sand0636/RFID/RFID-Network-Build-master/Documentation/images/data flow overview.png

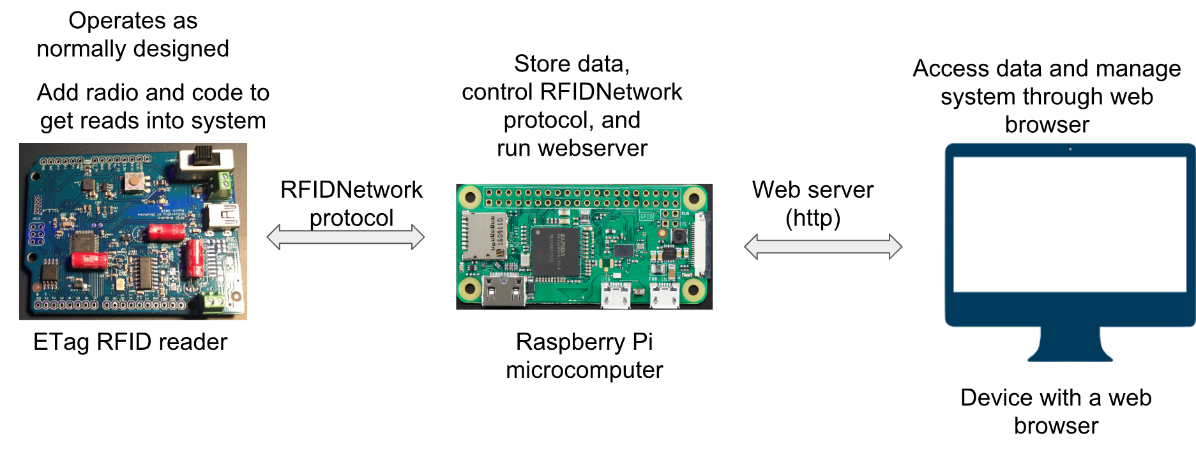
RFID-Network-Build-master/Documentation/images/data flow overview.png
