sand0636/RFID/RFID-Network-Build-master/other/3d test bracket/test1.stl

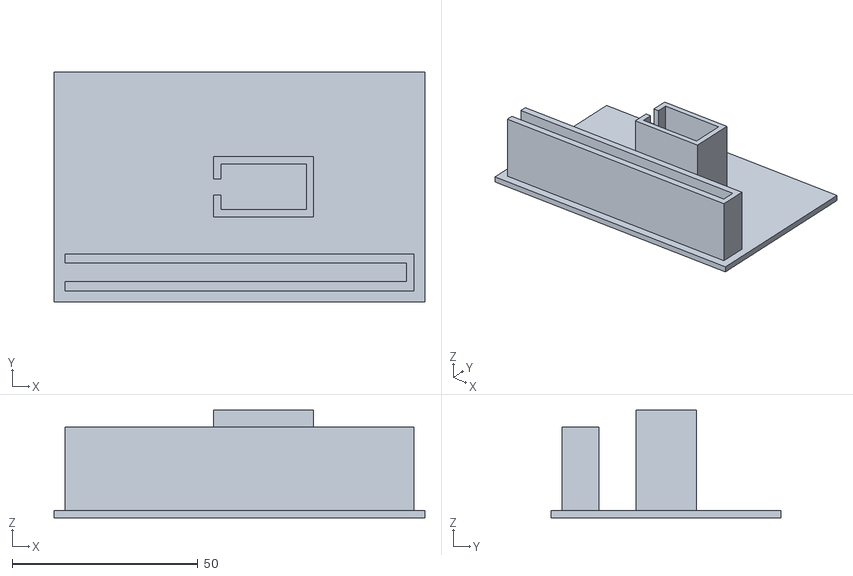
[picture p4: CAD file, 2019-05-10]
RFID-Network-Build-master/other/3d test bracket/test1.stl
100.0 x 62.0 x 29.0
