sand0636/RFID/RFID-Network-Build-master/other/3d test bracket/test2.stl

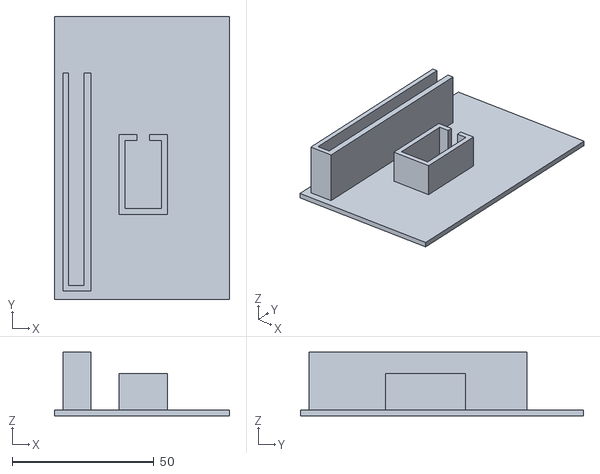
[picture p5: CAD file, 2019-05-10]
RFID-Network-Build-master/other/3d test bracket/test2.stl
62.0 x 100.0 x 22.5
