sand0636/RFID/(list of files, cad)

Other CAD files:
RFID-Network-Build-master/other/3d test bracket/test1_recover.dwg
RFID-Network-Build-master/other/3d test bracket/test1.dwg
RFID-Network-Build-master/other/3d test bracket/test2.dwg
