sand0636/RFID/RFID-Network-Build-master/Documentations/readme.md

# Documentation

This folder contains the documentation for the project.  Most of the documentation hasn't been started but it should be updated in a couple months.

## Contents:
- Images: Contains screenshots from the RPi installation process not currently used and images demonstrating the importance of a mesh layer.
- Protocol: A collection of protocol used in the system that will be included in the final tecnical manual.
- suggestions: A collection of hints and strategies to help with development and generally making life easier.
