sand0636/RFID/RFID-Network-Build-master/server/secure/settings.html

# Settings

- System information
- Wireless
- Radio
- Save data
- Database
  - Add test data
  - Delete table data

#### System information

Server type:

Field site Other

System name:

Submit

System time:

System timezone:

System up time:

Architecture:

Operating system:

CPU usage:

Free memory:

Total memory:

Percent memory used:

##### Reboot or shutdown system

Reboot Shutdown

#### Wireless

##### Wireless mode

Use access poing (create network) Use wifi (connect to network)

Use the device as an access point(ap) (creates a network where you can connect to the RPi using a wifi equipped device) or with wifi (connect to a network using the RPi). The currently used option is in blue. It is best ot use the RPi in AP mode when it is in the field so you can connect to it. This requires the system to reboot which may take up to a minute!

##### Access point

SSID (name):

Passphrase:

Change access point SSID or assphrase

##### WiFi

This does not show every WiFi saved on the RPi, only the one saved in settings.json. So don't be alarmed if you don't see a WiFi listed here that you haven't entered.

SSID (name):

Passphrase:

Change WiFi SSID or passphrase

#### Save data

This is where you can easily download data off of the server. Bird, box and reads data are stored as seporate CSVs and placed in one ZIP. This ZIP is only created when it is told to by pressing the "Update ZIP" button. The data can be downloaded through the browser by pressing the "Download ZIP" button. If a USB is inserted into the Pi then the ZIP can quickly be saved onto the drive by pressing the "Place ZIP on flash drive" button.

Update ZIP Download ZIP Place ZIP on flash drive

#### Radio

On Off

CE:

CSN:

Channel:

Data rate:

PA level:

The system must be rebooted to change the radio settings. Submit

#### Database

##### Add test data

This adds test data to all of the tables in the database without deleting anything. The data that is entered can be seen below

###### Birds:

rfidTag | bandID | Sex | age | taggedDateTime | taggedLocation | comment
0123456789 | ABCDEFGHIJ | F | 17 | N/a | stl | sis
6666666666 | BENWASHERE | M | 20 | bd | stl | ben
9876543210 | HELLOTOALL | M | 13 | n/a | stl | bro
0246813579 | A0B1C2D3E4 | F | 1.5 | n/a | Bloomington | rand

Add test data

##### Delete all data

This deletes all the data from the selected database. This only affects the local server, but if this is the sync server it will affect all other servers. This cannot be undone!!!

Delete bird data Delete box data Delete reads data Delete all data
