sand0636/RFID/RFIDNetwork User Manual.pdf

# RFIDNetwork User Manual

### Ben S. Duggan Indiana University: School of Informatics, Computing and Engenering dugganbens@gmail.com

### Last edit: January 24, 2019 Pre-release v0.9.0

## Contents

1 Preface | 3
2 Instillation | 3
3 Server (Raspberry Pi) | 12
4 RFIDNetwork class (Arduino code) | 21

5 Protocols | 21
6 Tests | 21
7 Appendix | 21

## 1 Preface

RFID technology has become cheaper and more accessible making it possible for a large number of readers to be deployed. While this delivers a large amount of useful data it can be hard to collect and manage it. For this reason this system was designed which collects reads from RFID readers and wirelessly transmits them to a central server. The goal of the system was to make an open-source system to wireless collect, store and manage RFID data.

To implement the system each reader needs to have an Arduino and radio module. However, if the reader is Arduino based, like the ETAG, then only a radio module is needed. To save the read to the server you simply need to pass the RFID tag into the RFIDNetwork class and it will be wireless sent to the server. It is up to the person running the code to get the RFID tag onto the Arduino and into the RIFDNetwork class (as this is largely reader specific) but sample code for the ETAG is provided along with code to use get reads from readers with RS-232 serial port, like the Gen. 2 reader.

The server is a Raspberry Pi (RPi) microcomputer and the Zero W is recommended as it is low cost, low power and comes with a Wifi module, but any RPi should work. Additionally the server needs a real time clock (RTC) to know what time it is and a radio module to communicate with the Arduinos. The RPi stores all of the RFID reads it received and runs a web server that allows users to view or manage the RFID data.

All of the code and documentation is stored on GitHub at github.com/BenSDuggan/RFID-Network/. If you find a problem with the code you can email me at dugganbens@gmail.com or create and issue on the GitHub page.

## 2 Instillation

This section shows how to install the system. While I have tried to make the system easy to install, there are some things which cannot be avoided like soldering. Most of the things that you will find difficult are things lots of people have had to learn on their own (including me) so you shouldn’t be disgruntled. If you get stuck with something you can probably find the answer with a quick Google search. Most things are explained thoroughly but the one thing I can’t help with is teaching you to solder. Soldering is the technique to electrically connect two wires. If you haven’t soldered before just watch this video https://www.youtube.com/watch?v=BLfXXRfRIzY (or any other you can find) and practice on some spare wires. You can pick up a cheap soldering iron on amazon for less than $30.
With that said if you have any problems you can send me an email and I’ll try to help. I’ve also made a video showing the entire installation process. You can find it here: . make video

### 2.1 The radio

For this system to work every device in the network needs to communicate with each other. This is done using the nRF24L01+PA+LNA Wireless Transceiver or shortened to the nRF24. This is a 2.4-2.48 GHz transceiver which means that it can send and receive data at the same frequency your WiFi uses. Each radio has the option of using 126 different channels (different field sites) different transmission speeds (250 KBPS, 1 MBPS and 2 MBPS) and 4 different power settings. It can connect to 6 other radios (expanded to 127 in software) and has a <1 mA sleep power consumption. You can find out more about the radios by viewing the datasheet (https://www.sparkfun.com/datasheets/Components/SMD/nRF24L01Pluss_Preliminary_Product_Specification_v1_0.pdf). (https://www.sparkfun.com/datasheets/Components/SMD/nRF24L01Pluss_Preliminary_Product_Specification_v1_0.pdf)
There are two common versions of the nRF24: short range and long range (see long range below). From my testing the short range version are inadequate under almost all circumstances so only the long range should be used. The long range model has an advertised range of 1000 m but I have only tested up to 600 m (more on the radio tests in section 6.1). To allow for greater range and more than 6 radios to be connected a software library is used which creates a mesh network. This is explained in section 4.3. These radios and the RFIDNetwork class rely on the SPI protocol, so while it has only been tested on Arduinos and Raspberry Pis it should work on other microcontrollers that support SPI. You can also find everything needed with approximate pricing in the appendix (7.1)
The radio comes with 8 2.54 mm pins called male headers. The recommended way to connect the radio is by soldering male headers to the microcontroller and then connecting a wire with female headers between the microcontroller and radio. See the image below. A modification needs to be made to the radios to ensure reliable performance due to an inadequate supply of power to the IC of the radio. This can be done by buying a power module (seen in the image below) or soldering a 4.7µF-10µF capacitor between the ground and VCC pin (1 and 2) on the radio module.

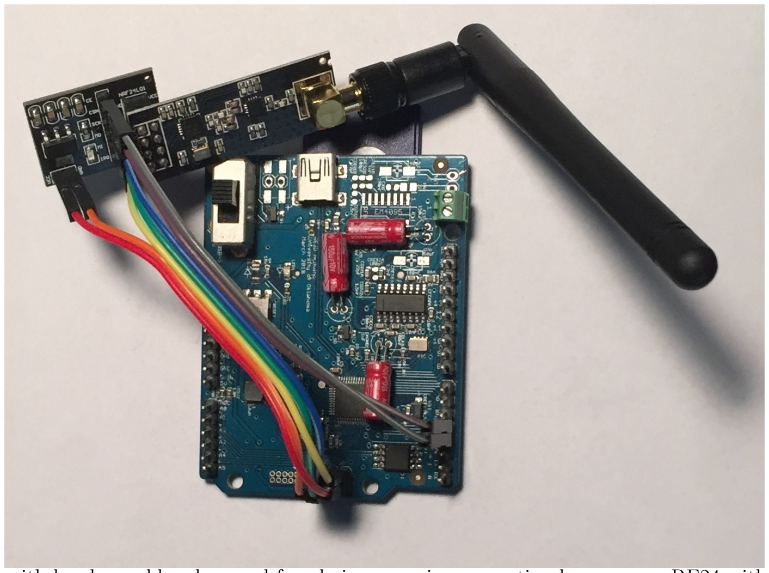
[picture p12: figure]

ETAG with headers soldered on and female jumper wire connecting long range nRF24 with power module to board.

### 2.1.1 Setting up the radio

The radio will come in a static protector bag. Take it out of the bag and screw the antenna onto the receptacle. It should look like the image above. To ensure reliable performance either a power module or capacitor needs to be added. The power module makes it easier to switch in the field but is more expensive and uses more power (due to having a power indicator LED)than the capacitor. The capacitor requires soldering but is cheaper and should result in the same performance.

Using the power module: Notice that there are two rows of 4 male pins on the radio and 2 rows of 4 female pins on the power module. Insert the radio into the power module so that all pins are seated. Next connect 7 female wires to the wires on the power module. Make sure that every pin on the power module is connected except for the pin labeled IRQ (looks like RO). Make sure that you only plug the VCC (pin 2) into 5V otherwise the module might get enough power. This should look like the picture above.

Using the capacitors: It is recommended to use a 4.7-10 capacitor with the radio. Solder the capacitor between pins 1 and 2 of the top of the radio (pin 1 has the white square around it and 2 is the the right, in the different row of 4 pins). If you’re using an electrolytic capacitor then make sure the negative lead is soldered to VCC. Next connect 7 female wires to the wires on the radio.

You don’t need to attached the IRQ (pin 8, located farthest away from pin 1 and on the side closer to the antenna). Make sure that you plug the VCC (pin 2) into 3.3V otherwise the module might get damaged. This should look like the picture below:

long range with capacitor and wires Long range nRF24 radio with capacitor and wires attached.

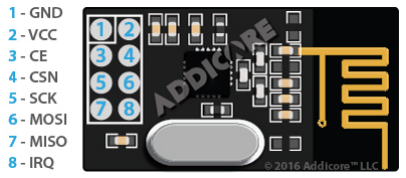
[picture p13: figure]

nRF24 pin layout with numbering and purpose.

### 2.2 Arduino (RFID reader)

The Arduino is used to get the RFID tag onto the server and saved. This system should work with any RFID reader but you need to get the reads onto an Arduino supported microcontroller. With Arduino based readers, like the ETAG, there is no need to purchase another Arduino as it is open-source and Arduino based. However, with other readers that aren’t Arduino based, like the Gen. 2 by Eli Bridge et al., a device must be used to get the reads onto an Arduino. This makes the setup more complicated and more expensive. We’ll use both of these RFID readers as examples of how this system can be setup. The software ran on the Arduinos is the same regardless of the reader, just will a few minor changes.

### 2.2.1 Hardware

Arduino based RFID readers (e.g. ETAG)

To connect the radio to the Arduino (either an Arduino based RFID reader or one that will be used to communicate with a reader) you just need to connect the jumper wires from the radio to the board. This means identifying which pins are used for SPI, digital, ground and power pins are (making sure you correctly use either 3.3V or 5V, depending on your configuration). The easiest way to identify where the SPI pins are is by using the 6 pin ISCP header. You may need to solder pins to it but it has as standard format (shown below). The VCC is likely at 5V so if you are using the capacitor you shouldn’t use this VCC and should use the 3.3V output pin and the board. The ISCP VCC pin on the ETAG is at 5V.

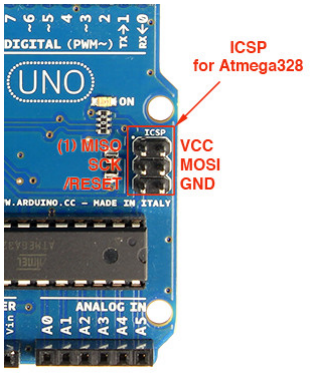
[picture p14: figure]

ISCP 6 pin header on Arudino Uno(ETAG) with pins labeled.

That takes care of GND, VCC, SCK, MOSI, MISO and IRQ (which isn’t used). The CE and CSN pin need to be connected to two digital pins and is defined in software. By default CE is set to digital pin 3 and CSN is set to digital pin 4 but you can change this if you’d like. This boils down to the following wiring as shown in the table below and the image showing the final setup.

Table showing pin connections between radio and Arduino.
Power module (from module) | Capacitor (from radio)
nRF24 pins | Arduino pins | nRF2 ins | Arduino pins
1. GND | GND on ICSP | 1. GND | GND on ICSP
2. VCC | 5V(VCC on ICSP) | 2. VCC | 3.3V on board
3. CE | digital pin 3 | 3. CE | digital pin 3
4. CSN | digital pin 4 | 4. CSN | digital pin 4
5. SCK | SCK on ICSP | 5. SCK | SCK on ICSP
6. MOSI | MOSI on ICSP | 6. MOSI | MOSI on ICSP
7. MISO | MISO on ICSP | 7. MISO | MISO on ICSP
8. IRQ | not used | 8. IRQ | not used

ETAG with headers soldered on and female jumper wire connecting long range nRF24 with power module to board (note that CE is connected to 2 and CSN is connected to 3).

This is all that needs to be done to setup the hardware on Arduino based RFID readers like the ETAG.

General way of adding system (e.g. Gen. 2)

For RFID readers that are not Arduino based, like the Gen. 2, there is a lot of work that needs to be done. The reason for this is that we need to get the RFID data off of the board and into the code, which is written for Arduinos. This means that you have to purchase an Arduino, any extra equipment to create an interface between the reader and Arduino and add the radio to it. Any Arduino should do but I recommend the Arduino Nano as it is common, cheap, low power, and easy to use. Once you do this attach the radio using the instructions above.
Next we need a way to get the data off of the RFID reader. RFID readers typically have a way for people to configure and see what tags the reader is currently reading. On the Gen. 2 there is a RS-232 serial port where you can attach a cable and connect it to your computer. When you connect to it you can view the settings and see what reads are coming into the reader. This provides us with a way to get the data off of the reader into an Arduino.
As Arduinos cannot us USB (without a shield), we’ll have to add a device that the Arduino understands, a RS232 to TTL with a null modem. Attach this to the Gen. 2 and try to secure it with screws. Make sure that you handle the Gen. 2 with care now as there is a large lever arm attached to the RS232 connector. Notice that there are 2 rows of 4 pins on the connector. Attach a wire to ground, VCC and txt pins (you may have to experiment with using the rxt pin). Check to see if the connector uses 3.3V or 5V (mine used 5V). Connect that wire to the pin giving that voltage on the reader. If the voltage of the connector and radio are the same and you only have one pin of that voltage you can plug the VCC cable from the radio into the extra VCC pin on the converter. Next connect the wire that leads to ground and the last wire to digital pin 5. This is the setup I went through with my RS232 to TTL converter (link in Appendix).
Lastly the Arduino needs to get powered. If the RFID reader has pins to output power (VCC) then you can solder wires to it and a ground pin. Make sure that the output voltage on the RFID reader is not greater than the input voltage the Arduino can take. If that condition holds then connect the VCC wire to the VIN pin on the Arduino and ground wire to the ground pin on the Arduino. If this is not an option on your RFID reader then you might be able to add wires to the battery powering the reader or just use a separate battery to power the Arduino.

gen. 2 setup Gen. 2 board with RS-232 to TTL and null modem and long range nRF24 connected to Arduino, powered by the Gen.2.

### 2.2.2 Software

If you don’t already have the Arduino IDE downloaded it from their website (https://www.arduino.cc/en/Main/Software) and install it. The Arduino scripts that work with this system are found in the arduino folder of the repository. If you haven’t already downloaded the GitHub repository (http://github.com/BenSDuggan/RFID-Network) you should do so now.
There are several codes that you can choose to upload. If you just want to test the code you should upload the send on interval code found in the sendOnInterval folder. There is a version of the code that works with all boards (sendOnIntervalAll) and one written just for the ETAG (sendOnIntervalETAG) that uses the SD card and RTC on the reader. If you are using the Gen. 2 or ETAG there is code provided that will read reads off of the antenna with out affecting reader performance. The Gen. 2 script is called RFIDNetworkGen2 and the ETAG script is called RFIDNetworkeETAG. Once you have selected the code you wish to use, connect the Arduino to the computer using the a USB, check to see that the correct board and port are selected. You’re can now upload the code by clicking the upload button.

### 2.3 Server

The server is central brains of the system. It is responsible for communicating with the RFID readers, saving data, making it viewable and more. Each field site needs one server. The server is designed to be a Raspberry Pi (RPi) mini computer. These are less than $20 and provide a full Linux interface. It is recommended to use the Raspberry Pi Zero W as it is small, low power, inexpensive and has WiFi included but it should work with any Raspberry Pi.

rpi diagram Raspberry Pi Zero W

### 2.3.1 Hardware

Your RPi might come without the pins soldered on. If this is the case then solder the pins to the board. Pin 1 is the closest to the middle and the SD slot and pin 2 is next to in on the other long set of pins. You can view the Raspberry Pi pins at pinout.xyz/.
In addition to the RPi you will need a radio for it and a real time clock (RTC). The RTC allows the RPi to know what time it is, which is not possible in the field where there is no internet. The RTC module connects to the RPi using pins 1,3,5,7,9 with pin 1 connected to the VCC (+) pin on the RTC. Next the radio needs to be connected per the table below.

Table showing pin connections between radio and Rapsberry Pi.
Power module (from module) | Capacitor (from radio)
nRF24 pins | Arduino pins | nRF2 ins | Arduino pins
1. GND | Pin 20 | 1. GND | Pin 20
2. VCC | Pin 4 | 2. VCC | Pin 17
3. CE | Pin 22(GPIO 25) | 3. CE | Pin 22(GPIO 25)
4. CSN | Pin 24 | 4. CSN | Pin 24
5. SCK | Pin 23(GPIO 11) | 5. SCK | Pin 23(GPIO 11)
6. MOSI | Pin 19(GPIO 10) | 6. MOSI | Pin 19(GPIO 10)
7. MISO | Pin 21(GPIO 9) | 7. MISO | Pin 21(GPIO 9)
8. IRQ | not used | 8. IRQ | not used

The RPi should now look like this:

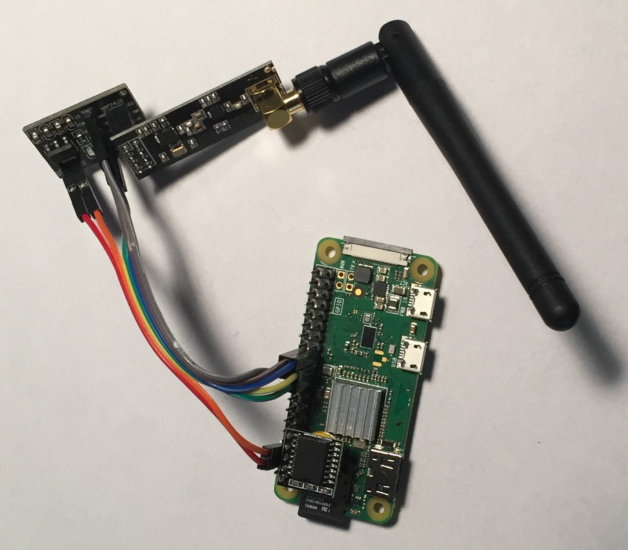
[picture p15: figure]

Raspberry Pi Zero W with RTC and radio.

### 2.3.2 Software

Download the zip of the NOOBs (new out of box) operating system for the Raspberry Pi found at https://www.raspberrypi.org/downloads/noobs/. Unzip the folder and install it according the the readme instructions. Install the operating system. If you have problems with this step you can refer to this video https://www.youtube.com/watch?v=iJbjAJpJA84.
Now you need to install the RFID Network software. This can be done automatically or manually. The manual installation instructions, which are incredibly tedious, are found in the following path: RFIDNetwork RPi install list.md. For that reason you probably want to use the automatic script. Start by opening the terminal by clicking the icon in the top left corner that is a gray rectangle with white text that looks like ”> ” (shown below). If you only have a key board plugged in you can click the windows key, arrow down to Accessories, arrow right, arrow down to Terminal and press enter.


RPi desktop showing terminal icon.

The terminal is a text only interface where you type commands and then run them by typing enter. Type ”wget https://bit.ly/2CCI6Ok” then press enter. Next type ”chmod +x 2CCI6Ok” and press enter. Finally type ”./2CCI6Ok” and type enter. This will start the instillation process. It’s recommended that you type ”y” when promoted to enter a yes or no answer. Remember which password you set for the admin username and password as it is used for the database and secure server settings. there is currently no way to change the username or password without doing it yourself.

## 3 Server (Raspberry Pi)

### 3.1 How to use

### 3.2 Settings

### 3.3 Battery management system

The website has a simple way to keep track of the remaining life of the battery. As the system doesn’t have access to the actually remaining battery life it is estimated using the the average power consumption of the board, battery capacity and the date when the battery was changed last. The data for this is stored in the boxes table of the database with the name ‘ mysql table name; standardize across boxes.html and database ’. If you won’t wish to use the feature then simply ignore it and nothing will be effected.

This feature works by calculating the estimated time the reader can stay on using the calculation below:

reader on time = batterycapacity(mAH) averagepowerconsumption

The battery capacity is a figure found on the battery you’re using while the average power consumption can be calculated theoretically or found experimentally. To calculate the theoretical average power consumption you can use the formula below:

average power consumption =

tawake·

tpollT ime·IantennaCurrent+tpauseT ime·IidleCurrent tpolltime+tsleep

+tsleep·Isleep

tawake+tsleep

The table below shows what each variable means and the approximate values for those variables on the ETAG and Gen. 2 board:

Variable | Meaning | ETAG value | Gen.2 value
tawake | hours board spends on during 1 day | 14 H | 14 H
tpollT ime | milliseconds antenna spends on during poll | 300 ms | 300 ms
IantennaCurrent | milliamps the board uses while scanning for tags | 125 mA | 45 mA
tpauseT ime | milliseconds antenna spends on during poll | 100 ms | 100 ms
IidleCurrent | milliamps the board uses while on but not scanning | 11 mA | need number mA
tsleep | hours board spends on during 1 day | 10 H | 10 H
Isleep | milliamps the board uses while sleeping | 1 mA | need number mA

*Note: tsleep + tawake should equal 24 hours

This method gives a rough estimate of the average power consumption but it not alway easy for people to calculate this number. A simpler way to find the average power consumption is to determine how long the reader stays on a given set of parameters. Then you can calculate the average power consumption using the following formula:

average power consumption mA = battery capacity(mA·H)
on time(H)
Note: The average power consumption will change if any of the RFID reader settings change

Once the estimated time the board can stay on has been calculated it is compared with the last time the battery was changed. The time remaining and percent time remaining on is calculated using the formulas below:

time remaining on = reader on time - [current time since epoch (hours) - battery change time since epoch (hours)]
percent time remaining = time remaining on
reader on time · 100%

The battery change time for a reader can be changed to the current time by clicking the on the reader and then clicking the “Change battery button”. The date can be manually set by clicking on the reader, clicking edit and then changing the date-time.

The results for these calculations are shown in two ways: if you look at a reader then you can see the estimated date that the reader will die or you can look at the color of the row. The row color represents the percent battery life remaining and the colors have the following values:

### 3.4 Front-end (website)

This section is intended to help people understand how the front-end web code is written. This section should help with adding new pages or editing existing ones.
The web front-end is designed using HTML, CSS and JavaScript and relies heavily on Socket.io (seamless communication between client and sever via web sockets), jQuery (better JavaScript) and Bootstrap (cohesive design).

### 3.4.1 Style

The styling is done using Bootstrap v4.0.0-beta.3. The style and script files are loaded in the header section of each page. For a consistent theme use the bootstrap classes outlined below. You can see an example page in ”template.html” and use it to make custom pages. Additionally the Bootstrap documentation (https://getbootstrap.com/docs/4.2/getting-started/introduction/) should help with most of your formating concerns.

Listing 1: ”template.html” <!−−
∗ Ben Duggan
∗ 8/8/18
∗ B a s ic page framework
−−>

<!DOCTYPE html>
<html>
<head>
<meta charset=” u tf −8”>
<meta name=” viewpo r t ” content=” width=d e vi c e−width , i n i t i a l − s c a l e =1, s h ri n k−to−f i t=no”>

<t i t l e>Template − RFID Network</ t i t l e>

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

<s cr ipt src=”/ dependence s / j s L i b r a r i e s / j que r y −3. 2. 1. min . j s ”></ s cr ipt>
<s cr ipt src=”/ dependence s / boo t s t ra p / j s / boo t s t ra p . min . j s ”></ s cr ipt>
<s cr ipt src=”/ s o c k e t . i o / s o c k e t . i o . j s ”></ s cr ipt>
<s cr ipt src=”/ dependence s /main . j s ”></ s cr ipt>
</head>
<body>
<nav c l a s s=” navbar navbar−expand−md navbar−dark bg−primary ”>

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

Navigation bar

The navigation bar should be the first item placed at the top of each page. This is the default navigation bar. If you want to add a tab to a page you simply need to copy the list item (li), change the href and display text. Copy this across each html document. The class ”active” should be added to the list item who’s href matches the html page you’re on (so this code came from birds.html as the active class is one of it’s attributes).
The navigation bar automatically compacts on mobile screens and replaces the tabs with a hamburger (3 lined bar) which can be clicked to display the pages.

Listing 2: ”Navigation bar style” <nav c l a s s=” navbar navbar−expand−md navbar−dark bg−primary ”> <a c l a s s=” navbar−brand” href=”/”>RFID Network</a>

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

Error bar and main div

After the navigation bar you should add a div where errors can be placed with id=errorsContainer. The back-end will attempt to send an error to all users whenever one is detected so it is good to add this feater to each page. After the error div you should add a div with classes ”container” and ”container-main”. All the code that is normally displayed, apart from the nav bar and any scripts loaded after the body, should be placed in this main div. This ensures that the proper margins and padding will be kept across the page.

Listing 3: ”Error bar and main div” <div id=” e r r o r s C o n t ai n e r ”></div>
<div c l a s s=” c o n t ai n e r co n tai n e r−main”> <!−− Pl ace your html code he re −−> </div>

Other styling items

When placing items next to each other it is best to use a grid. This allows the content to be dynamically resized when the screen size reaches a certain resolution.

Listing 4: ”Bootstrap grid” <div c l a s s=” row”>
<div c l a s s=” col−md−4”>

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

Tables are used to display lots of data. All tables use the stripped class, except when adding coloring (like with the battery management).

Listing 5: ”Bootstrap table” <tab le c l a s s=” t a b l e ta bl e−s t r i p e d ”> <thead>
<tr>
<th>Header 1</th><th>Header 2</th> </ tr>
</thead>
<tbody>
<tr>
<td>Body 1</td><td>Body 2</td> </ tr>
</tbody>
</ tab le>

Most buttons use the primary class as it goes with the overall blue color scheme.

Listing 6: ”Bootstrap button” <button type=” button ” c l a s s=” btn btn−primary ” id=” button−i d ”>Button t e x t</button>

### 3.4.2 Scripting

The scripting on the front-end is done using JavaScript with jQuery (better js), socket.io (serverclient communication), select2(auto complete inputs) and chart.js (creates nice looking charts). Not every page needs to include select2 and chart.js but you should include jQuery and the main.js script found in the dependencies folder.
main.js

The main.js script, found in RFID-Network/server/dependencies/main.js, is used to setup several variables, methods and page settings. The most important thing this script does is create a socket.io instance named socket. socket can be used in any other script called after main.js. Look at the socket.io client documentation (https://socket.io/docs/client-api/) to see how to use the library. The script also adds a prototype method called toSQLString to the Javascript Date class. This method is used to convert a Javascript

Date object to the correct MySQL format (also great for human readability). There are methods that check to see if the connection to the server is lost or gained. Finally, socket.on(”errorMessage”) that displays errors at the top of the screen when one happens.

Listing 7: ”main.js”
/∗
∗ Ben Duggan
∗ 12/14/18
∗ Reu sable j a v a s c r i p t code used by most page s ∗/

var s o c k e t = i o ( ) ;
var wa sDi sconnec ted = f a l s e ;

// Fi x e s the problem of ISO s t y l e with timezone o f f s e t
// S ol u ti o n from − h t t p s : / / s t a c k o v e rfl o w . com/ q u e s ti o n s /17415579/how−to− i s o −8601−format−a−date−with−timezone−o f f s e t −in−j a v a s c r i p t
Date . p ro to t y p e . toSQLString = f u n c ti o n ( ) {
var t zo = −t h i s . g e tTim e zo n eOff s e t ( ) ,
d i f = t zo >= 0 ? ’+ ’ : ’ − ’ ,
pad = f u n c ti o n (num) {
var norm = Math . f l o o r (Math . abs (num) ) ; r e t u r n ( norm < 10 ? ’0 ’ : ’ ’ ) + norm ; } ;
r e t u r n t h i s . g e tF ullY ea r ( ) + ’−’ + pad ( t h i s . getMonth ( ) + 1 ) +
’−’ + pad ( t h i s . getDate ( ) ) +
’ ’ + pad ( t h i s . ge tHou rs ( ) ) +
’ : ’ + pad ( t h i s . ge tMinu te s ( ) ) +
’ : ’ + pad ( t h i s . g e tSe con d s ( ) ) ; }

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

var e r r = ’ ’ ;
f o r ( var c i n data ) { e r r += ”{<i>” + c + ”</i >: ” + data [ c ] + ”} ” ; }

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

Reads Viewer

The reads view displays the reads stored on the server and provides tools for subsetting and viewing the reads. There are three parts of the viewer. The first section is a filter that lets you enter tags, a date range or other parameters to filter the data by. The filtering works by concatenating each filter field into a long SQL string. This means that if you enter a RIFD tag and a box but that tag was never at the box nothing will show up. The second section shows bird and box analytics. The last section shows the raw reads. To add the reads viewer to a page place a div tag with id readsViewer where you want the viewer to be placed. Then add a script with src ”/dependences/readsViewer.js” at the end of the body tag. To load the content you need to call rvLoad(). You can load a filter by calling rvSetFilter() and placing a JSON object with the desired filter as a parameter (e.g. rfid:[”A0B1C2D3E4”]). You can also hide the content by calling rvHide(). You can see an example of how to use this below.

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

<s cr ipt src=”/ dependence s / j s L i b r a r i e s / j que r y −3. 2. 1. min . j s ”></ s cr ipt>
<s cr ipt src=” dependence s / boo t s t ra p / j s / boo t s t ra p . min . j s ”></
s cr ipt>
<s cr ipt src=”/ s o c k e t . i o / s o c k e t . i o . j s ”></ s cr ipt>
<s cr ipt src=”/ dependence s /main . j s ”></ s cr ipt>
</head>
<body>
<div id=” read sViewe r ”></div>
<s cr ipt src=”/ dependence s / read sViewe r . j s ”></ s cr ipt> <s cr ipt>
$ ( ’ document ’ ) . ready ( f u n c ti o n ( ) { r v S e t F i l t e r ({ r f i d : [ ”A0B1C2D3E4” ] } ) ; // Se t f i l t e r
rvLoad ( ) ; // Load vi ew e r i n t o di v with i d ” read sViewe r ”
}) ;
</ s cr ipt>
</body>
</html>

Socket calls

Socket.io is used to make a TCP websocket channel to allow for quick and seamless communication between the server and client. There are a variety of socket calls which can be made from the website and additional several things the website listens for. Here is a list of calls that the website can make to the server and the data they send.

Website socket.emit calls.
Name | Data | Usage

Listing 9: ”aaa”

### 3.5 Back-end (Node.js)

## 4 RFIDNetwork class (Arduino code)

### 4.1 Documentation

### 4.2 How to add to another reader

### 4.3 Understanding the mesh networking

## 5 Protocols

### 5.1 RFIDNetworkProtocol

### 5.2 Localized radio sleep

### 5.2.1 Purpose

There are two versions of the nRF24 radios commonly available: the short range and long range models. Based off our testing the short range antennas don’t provide sufficient performance as they have a small range, ¡100 m, and don’t poses the capability to transmit through our junction box enclosures. For this reason the long range antennas must be used. These antennas consume around 24-26 mA during all power and data rate settings and ¡ 1 mA when they power down, or sleep. Additionally, the radios aren’t always transmitting. They only transmit when they get a new RFID read or need the time updated.

## 6 Tests

### 6.1 Range

### 6.2 Power

### 6.3 Reliability

## 7 Appendix

### 7.1 Purchase list

Below is the table with the list of items that you to use this system.

Item | Description | Price | Link | Usage
Long range NRF24L01 + PA + LNA | Radio used by all components in system | $ 4.50 | http://a.co/d/gTyLiEB (http://a.co/d/gTyLiEB) | All
*nRF24 power module | des | $2.00 | http://a.co/d/4aO5gxl (http://a.co/d/4aO5gxl) | All
*4.7µF | capsitor soldered to pin 1&2 on nRF24 to fix power | $0.10 | http://a.co/d/geAsuhP (http://a.co/d/geAsuhP) | All
Female-to-female jumper wires | Connect compo-nents in the sys-tem | <$0.10 | http://a.co/d/8rEd3eV (http://a.co/d/8rEd3eV) | All
*5V Arduino Nano | Arduino used to interface with Gen. 2 | $4.50 | http://a.co/d/9YXtAxh (http://a.co/d/9YXtAxh) | Gen. 2
*RS-232 to TTL converter | Converts Gen.2 communica-tion to Arduino communication | $6.49 | http://a.co/d/5TbXOCu (http://a.co/d/5TbXOCu) | Gen. 2
*Null modem | Lets the con-verter work with the gen. 2 | $3.50 | http://a.co/d/6bGmY3q (http://a.co/d/6bGmY3q) | Gen. 2
Raspberry Pi Zero W | Low power RPi with WiFi | $20 | http://a.co/d/99oZjQa (http://a.co/d/99oZjQa) | Server
16Gb micro SD card | SD card for stor-age on the RPi | $11.00 | http://a.co/d/f0VfbtY (http://a.co/d/f0VfbtY) | server
DS3231 RTC | RTC used with RPi | $2.10 | http://a.co/d/elzvuFW (http://a.co/d/elzvuFW) | Server
item | des | price | | use
*Denotes not required

### 7.2 Code documentation/walk through

### 7.3 Dependencies

This section lists the dependence and versions used when building and testing the system.

Dependency | Version | Usage | Link
Raspberry Pi Noobs (Raspian) | 3.0.0 | Raspberry Pi OS | https://www.raspberrypi.org/
node.js | v9.9.0-linux-armv6l | Creates a Javascript server. | https://nodejs.org/en/ (https://nodejs.org/en/)
Bootstrap | v4.0.0-beta.3 | Web page styling | https://getbootstrap.com/
Socket.IO | v2.1.1 | server/client TCP web sockets | https://socket.io/
Select2 | 4.0.6-rc.0 | Drop down that auto fills input forms on the website | https://select2.org/ (https://select2.org/)
Chart.js | v2.7.2 | Creates nice looking, interactive charts on the website | http://chartjs.org/ (http://chartjs.org/)
