sand0636/RFID/RFID-Network-Build-master/server/outputCSV/rfidData.xlsx

Sheet: birds
"0123456789" | ABCDEFGHIJ | F | 17 | N/a | stl | sis
6666666666 | BENWASHERE | M | 20 | bd | stl | ben
9876543210 | HELLOTOALL | M | 13 | n/a | stl | bro
"0246813579" | A0B1C2D3E4 | F | 1.5 | n/a | Bloomington | rand

Sheet: boxes
E40 | B8 | -80.643 | 82.451
20 | B9 | -80.555 | 82.666
19 | B2 | -80.111 | 82.432

Sheet: Sheet3
ABCDEFGHIJ | "2018-06-01 07:05:34" | 20 | B9
ABCDEFGHIJ | "2018-06-01 07:05:34" | 20 | B9
ABCDEFGHIJ | "2018-06-01 07:05:34" | 20 | B9 | close times
ABCDEFGHIJ | "2018-06-01 07:06:38" | E40 | B8
ABCDEFGHIJ | "2018-06-01 07:40:34" | 19 | B2
BENWASHERE | "2018-06-01 07:05:34" | 19 | B2
BENWASHERE | "2018-06-02 08:05:34" | 19 | B2
BENWASHERE | "2018-06-03 14:05:34" | 19 | B2 | close dates
BENWASHERE | "2018-06-04 18:35:34" | 19 | B2
HELLLOTOALL | "2018-06-01 07:05:34" | E40 | B8
HELLLOTOALL | "2018-07-01 07:06:34" | 20 | B9
HELLLOTOALL | "2018-07-15 07:06:38" | 19 | B2
HELLLOTOALL | "2018-08-01 07:40:34" | E40 | B8
A0B1C2D3E4 | "2018-06-23 07:05:34" | E40 | B8
A0B1C2D3E4 | "2018-07-01 08:05:34" | E40 | B8
A0B1C2D3E4 | "2018-07-30 14:05:34" | 20 | B9
A0B1C2D3E4 | "2018-09-04 18:35:34" | 19 | B2
