sand0636/RFID/RFID-Network-Build-master/Documentation/images/data analytics.png

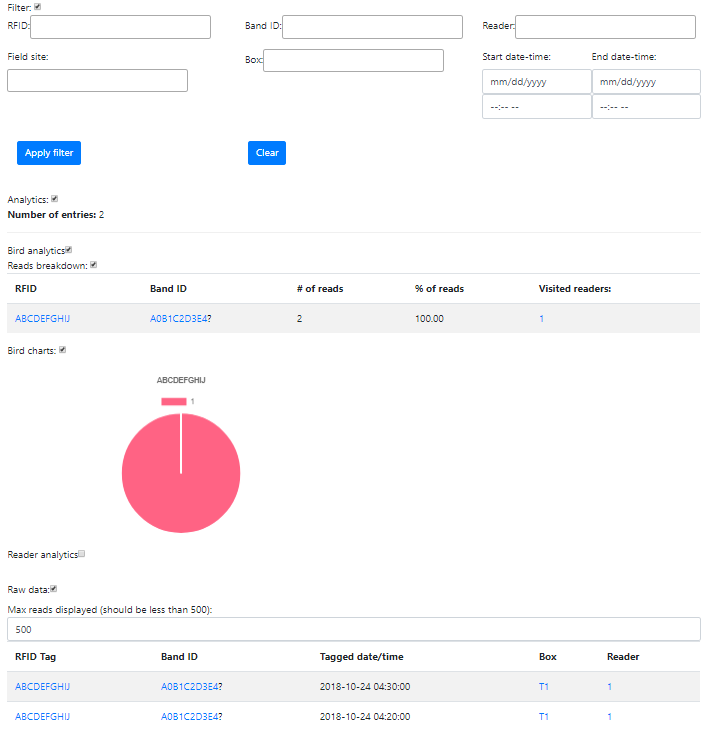
RFID-Network-Build-master/Documentation/images/data analytics.png
