sand0636/RFID/RFID-Network-Build-master/Documentation/images/Mesh Graphics/fullMesh.png

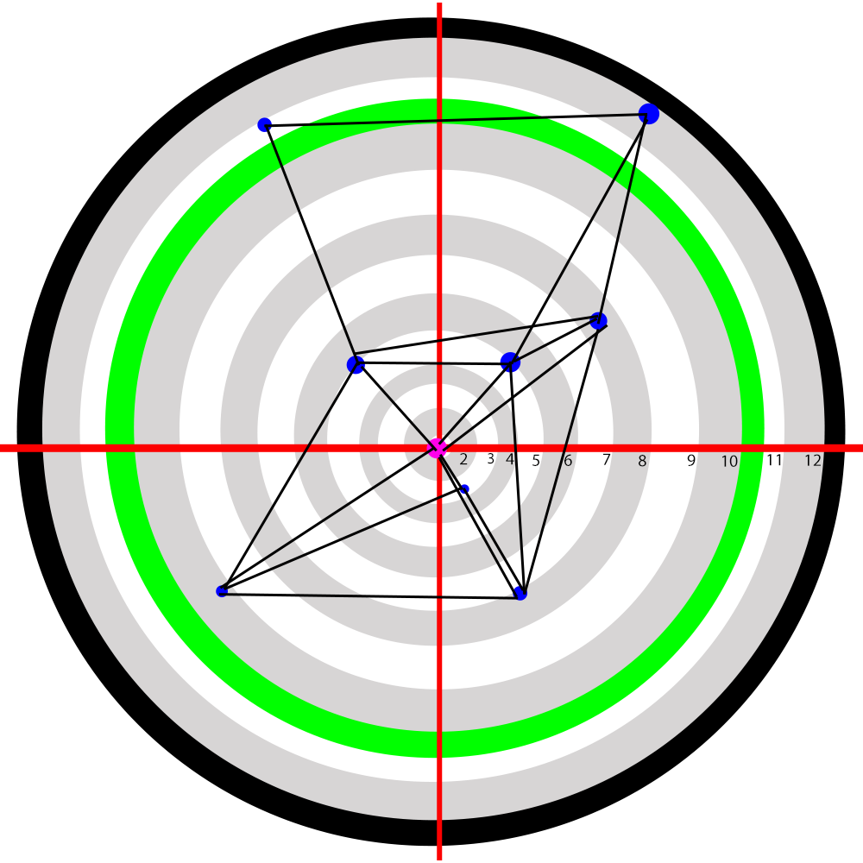
RFID-Network-Build-master/Documentation/images/Mesh Graphics/fullMesh.png
