sand0636/RFID/RFID-Network-Build-master/Documentation/images/Mesh Graphics/noMesh.png

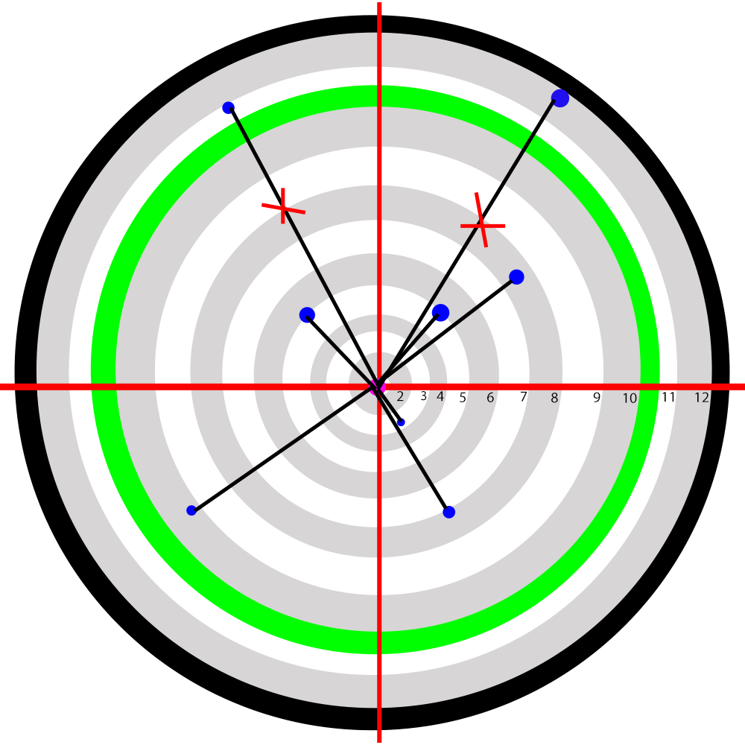
RFID-Network-Build-master/Documentation/images/Mesh Graphics/noMesh.png
