sand0636/RFID/RFID-Network-Build-master/Documentation/images/mesh network.png

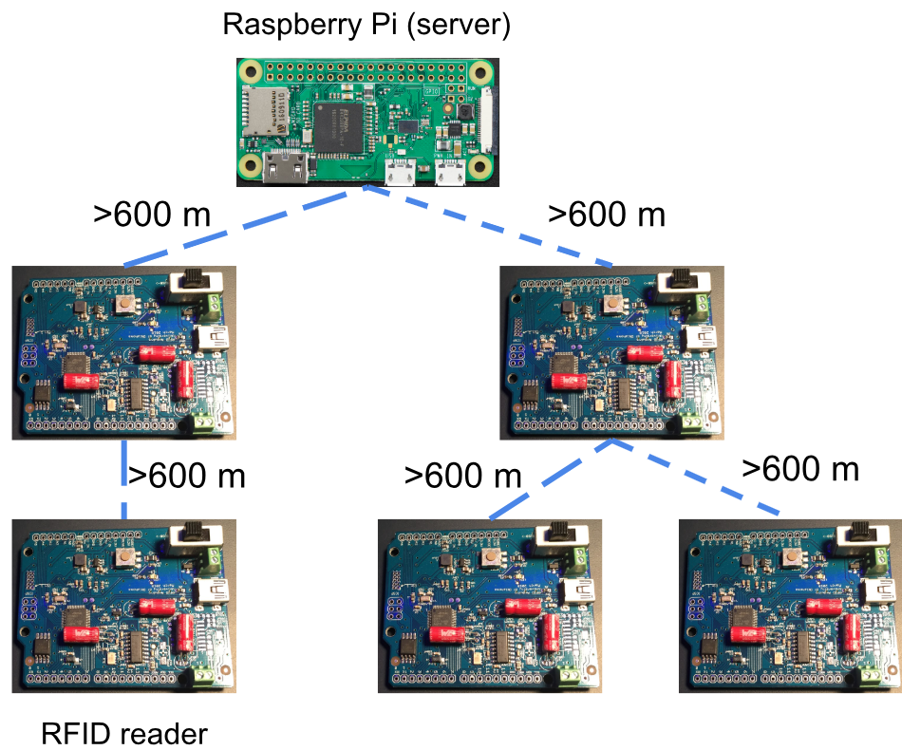
RFID-Network-Build-master/Documentation/images/mesh network.png
