sand0636/RFID/RFID-Network-Build-master/Documentation/images/nrf24 long range.jpg

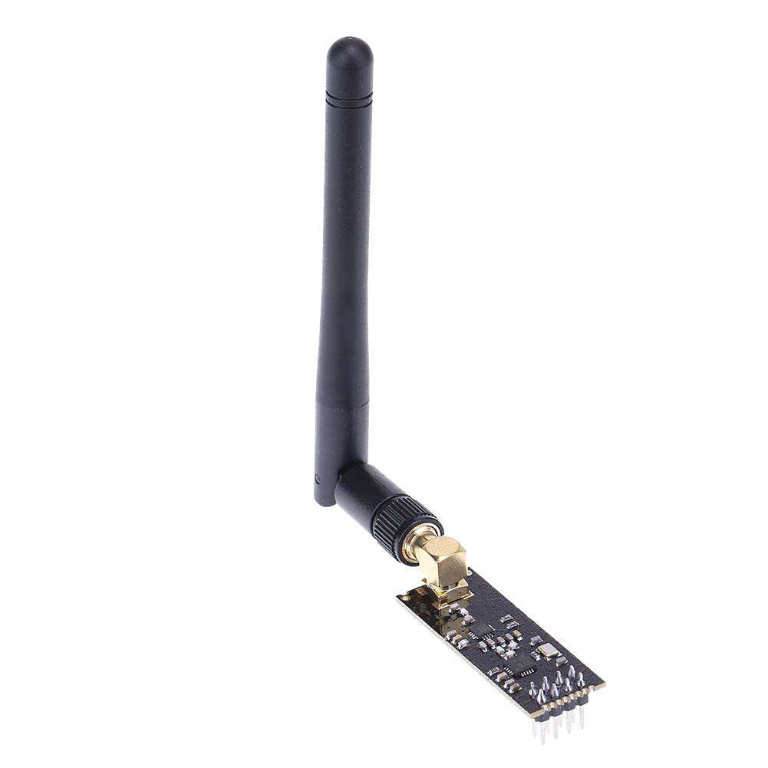
RFID-Network-Build-master/Documentation/images/nrf24 long range.jpg
