sand0636/RFID/RFID-Network-Build-master/Documentation/images/Pis/config screen.PNG

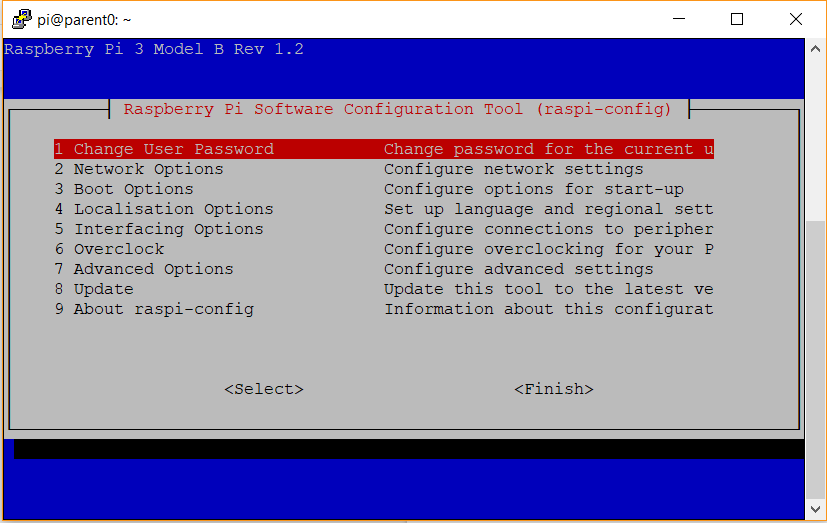
RFID-Network-Build-master/Documentation/images/Pis/config screen.PNG
