sand0636/RFID/RFID-Network-Build-master/Documentation/images/Pis/download.PNG

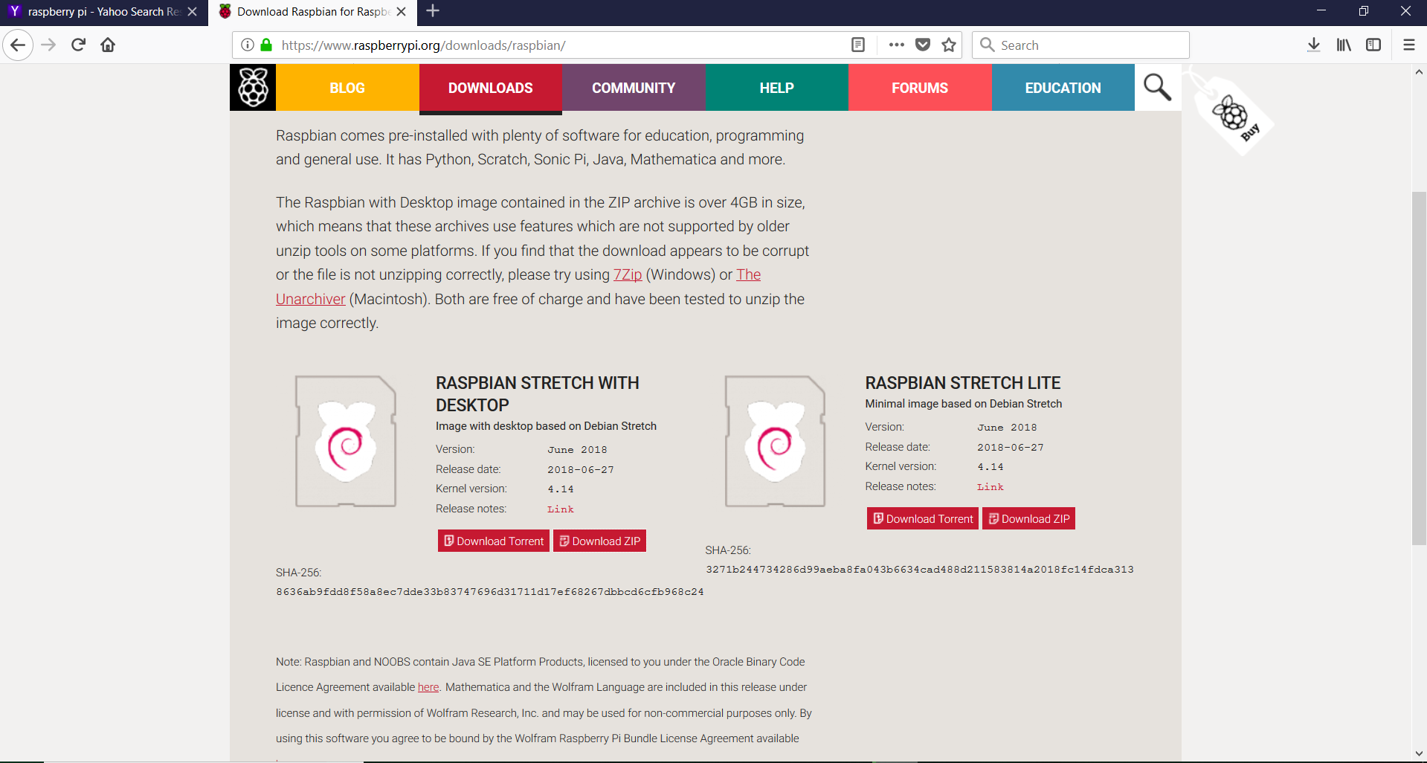
RFID-Network-Build-master/Documentation/images/Pis/download.PNG
