sand0636/RFID/RFID-Network-Build-master/Documentation/images/Pis/etcher.PNG

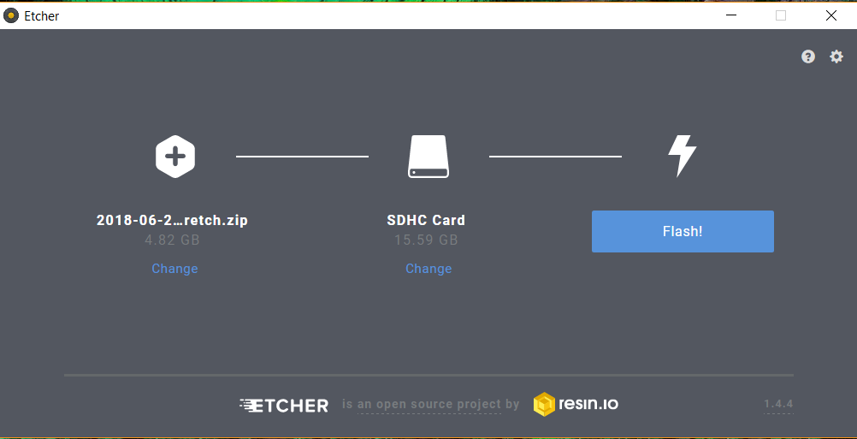
RFID-Network-Build-master/Documentation/images/Pis/etcher.PNG
