sand0636/RFID/RFID-Network-Build-master/Documentation/images/Pis/noobs-raspbian.PNG

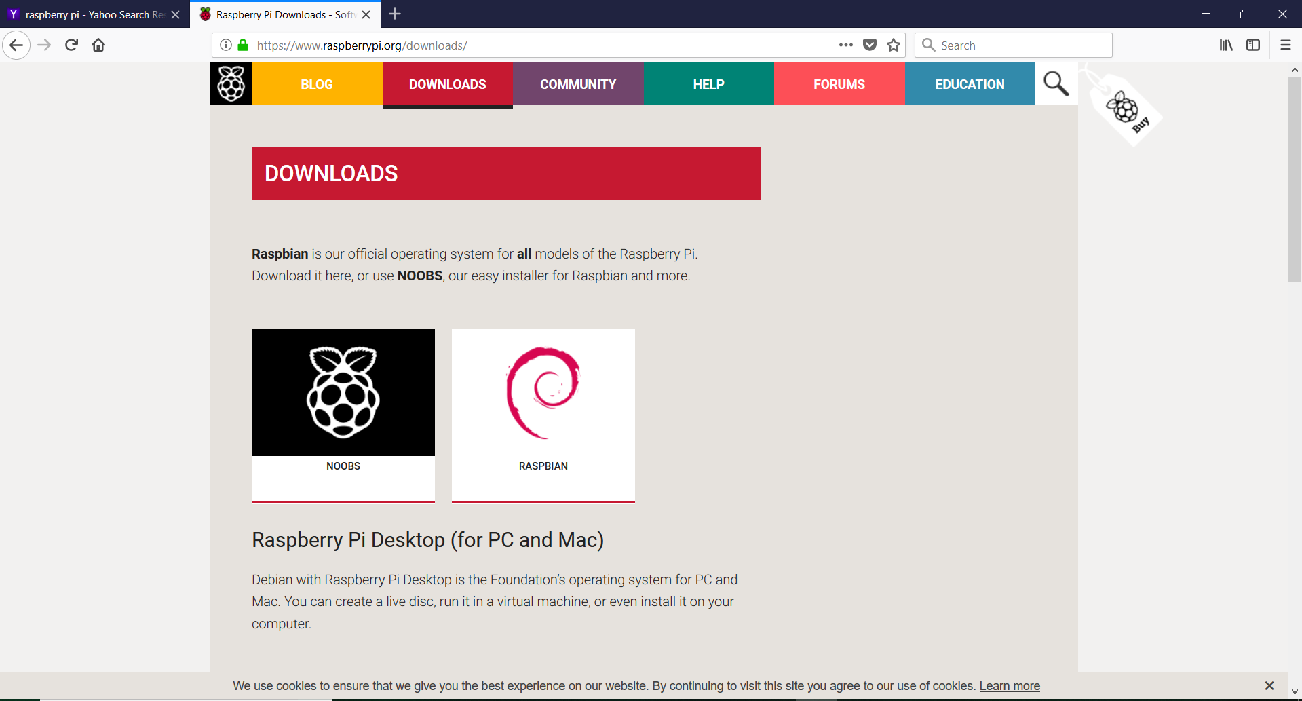
RFID-Network-Build-master/Documentation/images/Pis/noobs-raspbian.PNG
