sand0636/RFID/RFID-Network-Build-master/Documentation/images/Pis/pi login.PNG

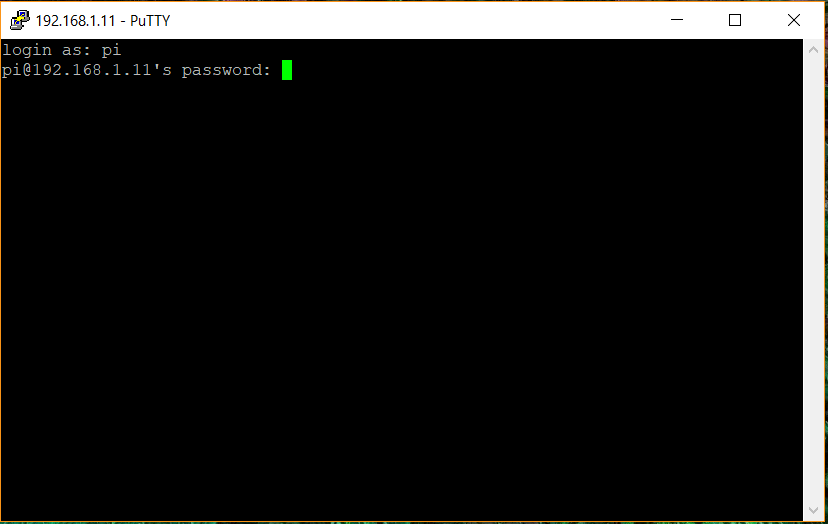
RFID-Network-Build-master/Documentation/images/Pis/pi login.PNG
