sand0636/RFID/RFID-Network-Build-master/Documentation/images/Pis/putty warning.PNG

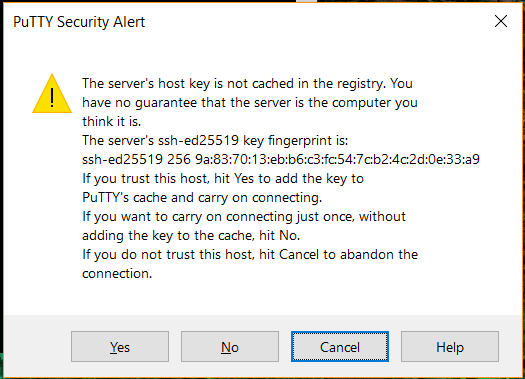
RFID-Network-Build-master/Documentation/images/Pis/putty warning.PNG
