sand0636/RFID/RFID-Network-Build-master/Documentation/images/Pis/putty with ip.PNG

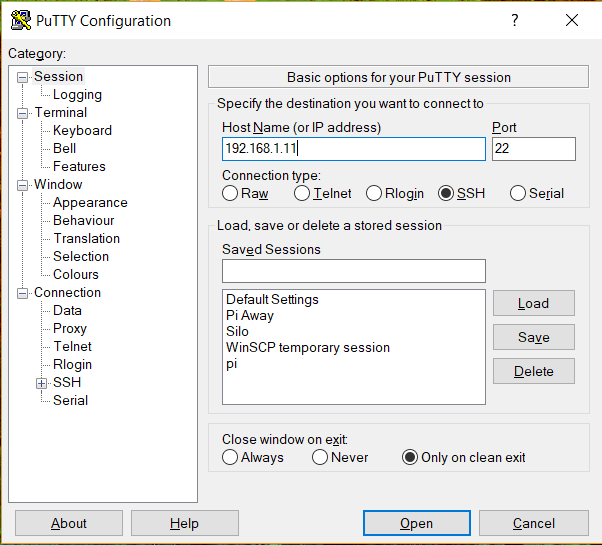
RFID-Network-Build-master/Documentation/images/Pis/putty with ip.PNG
