sand0636/RFID/RFID-Network-Build-master/Documentation/images/Pis/rasp-webgui home.PNG

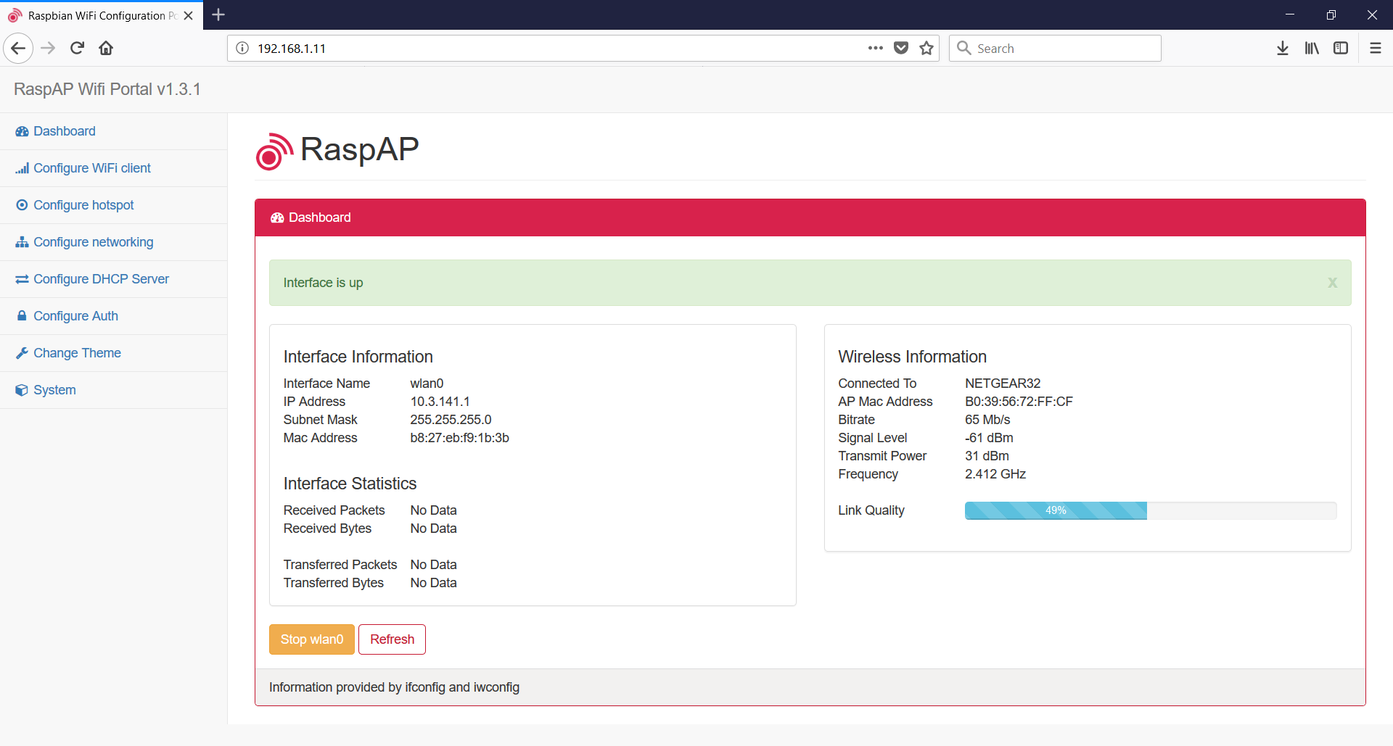
RFID-Network-Build-master/Documentation/images/Pis/rasp-webgui home.PNG
