sand0636/RFID/RFID-Network-Build-master/Documentation/images/Pis/raspap-webgui login.PNG

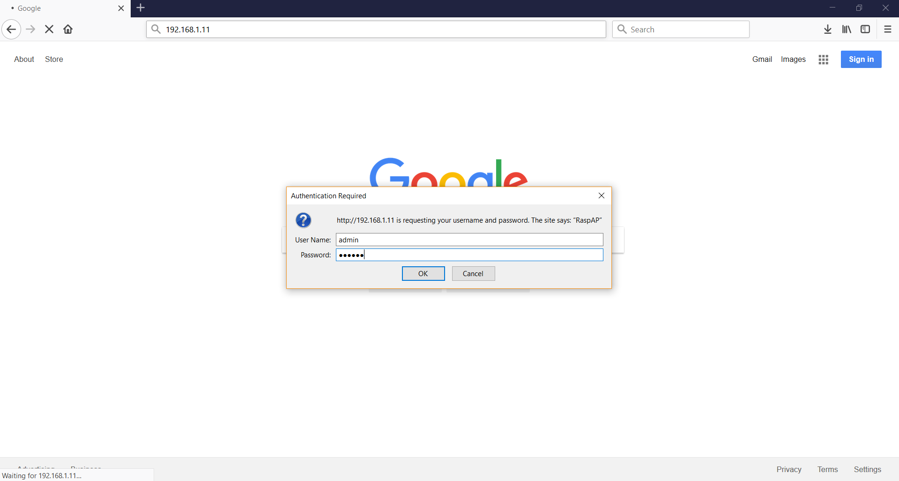
RFID-Network-Build-master/Documentation/images/Pis/raspap-webgui login.PNG
