sand0636/RFID/RFID-Network-Build-master/Documentation/images/website/webpage analytics bird,reader,raw.png

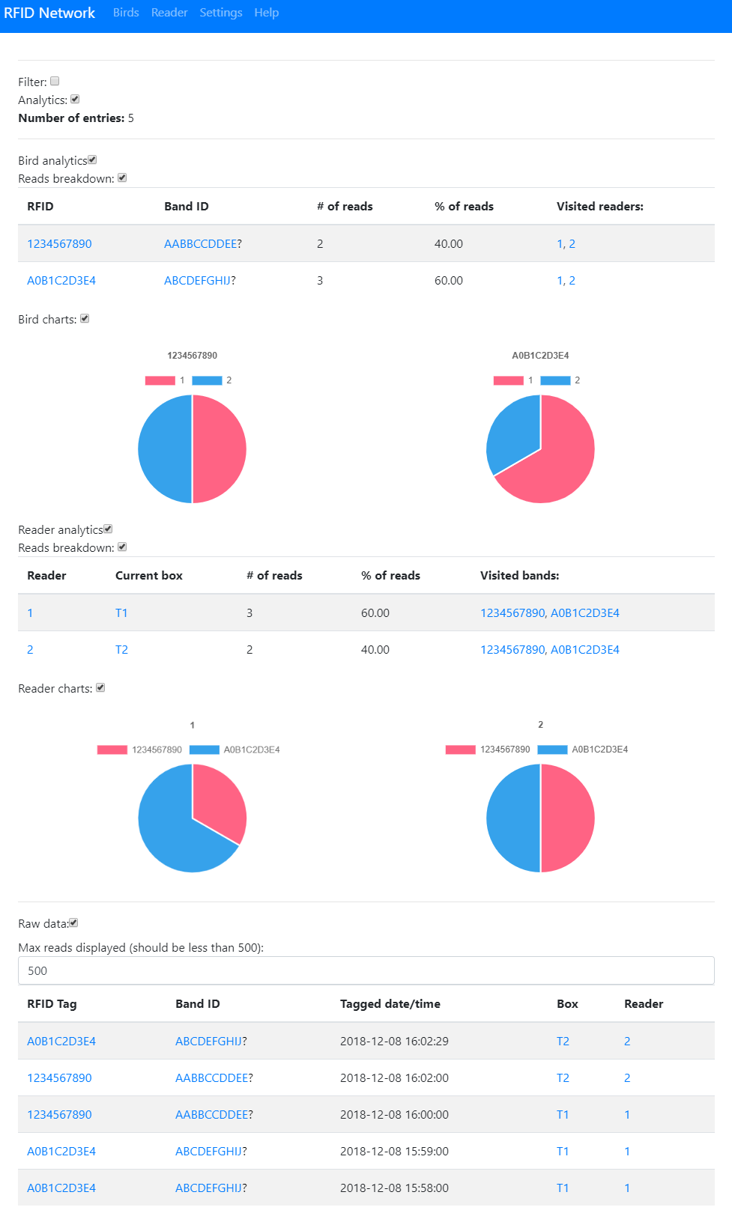
RFID-Network-Build-master/Documentation/images/website/webpage analytics bird,reader,raw.png
