sand0636/RFID/RFID-Network-Build-master/Documentation/images/website/webpage tags.png

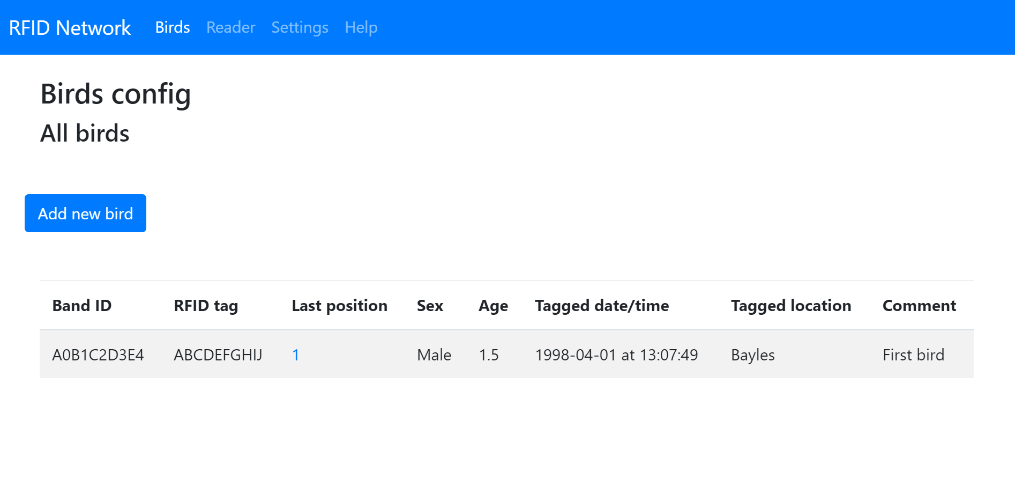
RFID-Network-Build-master/Documentation/images/website/webpage tags.png
