sand0636/RFID/RFID-Network-Build-master/Documentation/images/website/webpage-analytics-filter,bird,raw.png

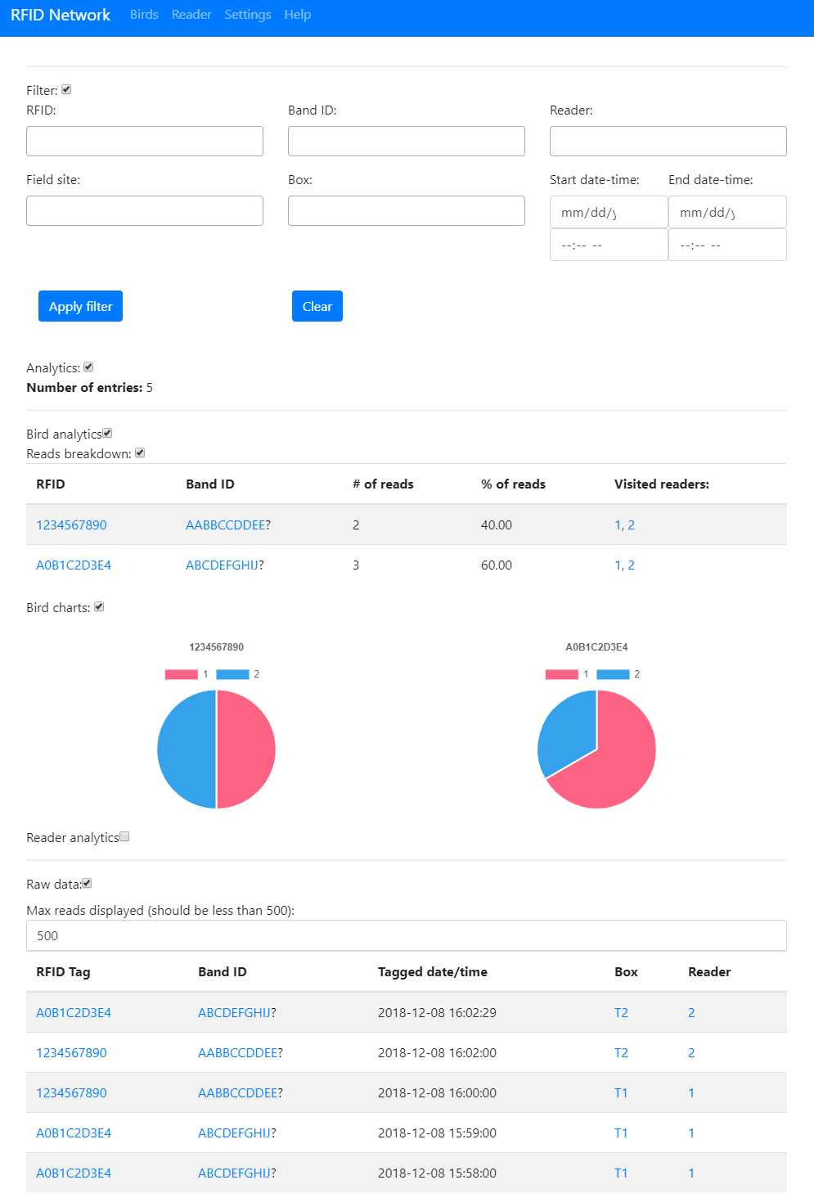
RFID-Network-Build-master/Documentation/images/website/webpage-analytics-filter,bird,raw.png
