sand0636/RFID/RFID-Network-Build-master/tests/batteryAndThermal/#2 -  hour temp test (4-14-18)/temp test 2 (4-14-18).txt

Start ambient = -- C
Start time = 4/14/2018 15:49:08
Start temp = 24.12 C

End ambient =   C
End time = 
End temp =  C

Notes: 
- In wells, first floor table
