sand0636/RFID/RFID-Network-Build-master/tests/Reads transfered sucessfully/Analyse Reads/10-23-18-2/TESTDATA.TXT

ABCDEFGHIJ 10/25/2018 22:52:56
ABCDEFGHIJ 10/25/2018 22:52:58
ABCDEFGHIJ 10/25/2018 22:53:0
ABCDEFGHIJ 10/25/2018 22:53:2
ABCDEFGHIJ 10/25/2018 22:53:4
ABCDEFGHIJ 10/25/2018 22:53:6
ABCDEFGHIJ 10/25/2018 22:53:8
ABCDEFGHIJ 10/25/2018 22:53:10
ABCDEFGHIJ 10/25/2018 22:53:12
ABCDEFGHIJ 10/25/2018 22:53:14
ABCDEFGHIJ 10/25/2018 22:53:16
ABCDEFGHIJ 10/25/2018 22:53:18
ABCDEFGHIJ 10/25/2018 22:53:20
ABCDEFGHIJ 10/25/2018 22:53:22
ABCDEFGHIJ 10/25/2018 22:53:24
ABCDEFGHIJ 10/25/2018 22:53:26
ABCDEFGHIJ 10/25/2018 22:53:28
ABCDEFGHIJ 10/25/2018 22:53:30
ABCDEFGHIJ 10/25/2018 22:53:32
ABCDEFGHIJ 10/25/2018 22:53:34
ABCDEFGHIJ 10/25/2018 22:53:36
ABCDEFGHIJ 10/25/2018 22:53:38
ABCDEFGHIJ 10/25/2018 22:53:40
ABCDEFGHIJ 10/25/2018 22:53:42
ABCDEFGHIJ 10/25/2018 22:53:44
ABCDEFGHIJ 10/25/2018 22:53:46
ABCDEFGHIJ 10/25/2018 22:53:48
ABCDEFGHIJ 10/25/2018 22:53:50
ABCDEFGHIJ 10/25/2018 22:53:52
ABCDEFGHIJ 10/25/2018 22:53:54
ABCDEFGHIJ 10/25/2018 22:53:56
ABCDEFGHIJ 10/25/2018 22:53:58
ABCDEFGHIJ 10/25/2018 22:54:0
ABCDEFGHIJ 10/25/2018 22:54:2
ABCDEFGHIJ 10/25/2018 22:54:4
ABCDEFGHIJ 10/25/2018 22:54:6
ABCDEFGHIJ 10/25/2018 22:54:8
ABCDEFGHIJ 10/25/2018 22:54:10
ABCDEFGHIJ 10/25/2018 22:54:12
ABCDEFGHIJ 10/25/2018 22:54:14
ABCDEFGHIJ 10/25/2018 22:54:16
ABCDEFGHIJ 10/25/2018 22:54:18
ABCDEFGHIJ 10/25/2018 22:54:20
ABCDEFGHIJ 10/25/2018 22:54:22
ABCDEFGHIJ 10/25/2018 22:54:24
ABCDEFGHIJ 10/25/2018 22:54:26
ABCDEFGHIJ 10/25/2018 22:54:28
ABCDEFGHIJ 10/25/2018 22:54:30
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
ABCDEFGHIJ 10/25/2018 23:4:44
ABCDEFGHIJ 10/25/2018 23:4:46
ABCDEFGHIJ 10/25/2018 23:4:48
ABCDEFGHIJ 10/25/2018 23:4:50
ABCDEFGHIJ 10/25/2018 23:4:52
ABCDEFGHIJ 10/25/2018 23:4:54
ABCDEFGHIJ 10/25/2018 23:4:56
ABCDEFGHIJ 10/25/2018 23:4:58
ABCDEFGHIJ 10/25/2018 23:5:0
