sand0636/RFID/RFID-Network-Build-master/tests/Reads transfered sucessfully/Analyse Reads/10-23-18-3/TESTDATA.TXT

ABCDEFGHIJ 10/25/2018 23:39:55
ABCDEFGHIJ 10/25/2018 23:39:57
ABCDEFGHIJ 10/25/2018 23:39:59
ABCDEFGHIJ 10/25/2018 23:40:1
ABCDEFGHIJ 10/25/2018 23:40:3
ABCDEFGHIJ 10/25/2018 23:40:5
ABCDEFGHIJ 10/25/2018 23:40:7
ABCDEFGHIJ 10/25/2018 23:40:9
ABCDEFGHIJ 10/25/2018 23:40:11
ABCDEFGHIJ 10/25/2018 23:40:13
ABCDEFGHIJ 10/25/2018 23:40:15
ABCDEFGHIJ 10/25/2018 23:40:17
ABCDEFGHIJ 10/25/2018 23:40:19
ABCDEFGHIJ 10/25/2018 23:40:21
ABCDEFGHIJ 10/25/2018 23:40:23
ABCDEFGHIJ 10/25/2018 23:40:25
ABCDEFGHIJ 10/25/2018 23:40:27
ABCDEFGHIJ 10/25/2018 23:40:29
ABCDEFGHIJ 10/25/2018 23:40:31
ABCDEFGHIJ 10/25/2018 23:40:33
ABCDEFGHIJ 10/25/2018 23:40:35
ABCDEFGHIJ 10/25/2018 23:40:37
ABCDEFGHIJ 10/25/2018 23:40:39
ABCDEFGHIJ 10/25/2018 23:40:41
ABCDEFGHIJ 10/25/2018 23:40:43
ABCDEFGHIJ 10/25/2018 23:40:45
ABCDEFGHIJ 10/25/2018 23:40:47
ABCDEFGHIJ 10/25/2018 23:40:49
ABCDEFGHIJ 10/25/2018 23:40:51
ABCDEFGHIJ 10/25/2018 23:40:53
ABCDEFGHIJ 10/25/2018 23:40:55
ABCDEFGHIJ 10/25/2018 23:40:57
ABCDEFGHIJ 10/25/2018 23:40:59
ABCDEFGHIJ 10/25/2018 23:41:1
ABCDEFGHIJ 10/25/2018 23:41:3
ABCDEFGHIJ 10/25/2018 23:41:5
ABCDEFGHIJ 10/25/2018 23:41:7
ABCDEFGHIJ 10/25/2018 23:41:9
ABCDEFGHIJ 10/25/2018 23:41:11
ABCDEFGHIJ 10/25/2018 23:41:13
ABCDEFGHIJ 10/25/2018 23:41:15
ABCDEFGHIJ 10/25/2018 23:41:17
ABCDEFGHIJ 10/25/2018 23:41:19
ABCDEFGHIJ 10/25/2018 23:41:21
ABCDEFGHIJ 10/25/2018 23:41:23
ABCDEFGHIJ 10/25/2018 23:41:25
ABCDEFGHIJ 10/25/2018 23:41:27
ABCDEFGHIJ 10/25/2018 23:41:29
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
ABCDEFGHIJ 10/25/2018 23:53:39
ABCDEFGHIJ 10/25/2018 23:53:41
ABCDEFGHIJ 10/25/2018 23:53:43
ABCDEFGHIJ 10/25/2018 23:53:45
ABCDEFGHIJ 10/25/2018 23:53:47
ABCDEFGHIJ 10/25/2018 23:53:49
ABCDEFGHIJ 10/25/2018 23:53:51
ABCDEFGHIJ 10/25/2018 23:53:53
ABCDEFGHIJ 10/25/2018 23:53:55
