sand0636/RFID/RFID-Network-Build-master/tests/Reads transfered sucessfully/Analyse Reads/10-23-18/TESTDATA.TXT

ABCDEFGHIJ 10/24/2018 13:5:55
ABCDEFGHIJ 10/24/2018 13:5:57
ABCDEFGHIJ 10/24/2018 13:5:59
ABCDEFGHIJ 10/24/2018 13:6:1
ABCDEFGHIJ 10/24/2018 13:6:3
ABCDEFGHIJ 10/24/2018 13:6:5
ABCDEFGHIJ 10/24/2018 13:6:7
ABCDEFGHIJ 10/24/2018 13:6:9
ABCDEFGHIJ 10/24/2018 13:6:11
ABCDEFGHIJ 10/24/2018 13:6:13
ABCDEFGHIJ 10/24/2018 13:6:15
ABCDEFGHIJ 10/24/2018 13:6:17
ABCDEFGHIJ 10/24/2018 13:6:19
ABCDEFGHIJ 10/24/2018 13:6:21
ABCDEFGHIJ 10/24/2018 13:6:23
ABCDEFGHIJ 10/24/2018 13:6:25
ABCDEFGHIJ 10/24/2018 13:6:27
ABCDEFGHIJ 10/24/2018 13:6:29
ABCDEFGHIJ 10/24/2018 13:6:31
ABCDEFGHIJ 10/24/2018 13:6:33
ABCDEFGHIJ 10/24/2018 13:6:35
ABCDEFGHIJ 10/24/2018 13:6:37
ABCDEFGHIJ 10/24/2018 13:6:39
ABCDEFGHIJ 10/24/2018 13:6:41
ABCDEFGHIJ 10/24/2018 13:6:43
ABCDEFGHIJ 10/24/2018 13:6:45
ABCDEFGHIJ 10/24/2018 13:6:47
ABCDEFGHIJ 10/24/2018 13:6:49
ABCDEFGHIJ 10/24/2018 13:6:51
ABCDEFGHIJ 10/24/2018 13:6:53
ABCDEFGHIJ 10/24/2018 13:6:55
ABCDEFGHIJ 10/24/2018 13:6:57
ABCDEFGHIJ 10/24/2018 13:6:59
ABCDEFGHIJ 10/24/2018 13:7:1
ABCDEFGHIJ 10/24/2018 13:7:3
ABCDEFGHIJ 10/24/2018 13:7:5
ABCDEFGHIJ 10/24/2018 13:7:7
ABCDEFGHIJ 10/24/2018 13:7:9
ABCDEFGHIJ 10/24/2018 13:7:11
ABCDEFGHIJ 10/24/2018 13:7:13
ABCDEFGHIJ 10/24/2018 13:7:15
ABCDEFGHIJ 10/24/2018 13:7:17
ABCDEFGHIJ 10/24/2018 13:7:19
ABCDEFGHIJ 10/24/2018 13:7:21
ABCDEFGHIJ 10/24/2018 13:7:23
ABCDEFGHIJ 10/24/2018 13:7:25
ABCDEFGHIJ 10/24/2018 13:7:27
ABCDEFGHIJ 10/24/2018 13:7:29
ABCDEFGHIJ 10/24/2018 13:7:31
ABCDEFGHIJ 10/24/2018 13:7:33
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
ABCDEFGHIJ 10/24/2018 16:42:54
ABCDEFGHIJ 10/24/2018 16:42:56
ABCDEFGHIJ 10/24/2018 16:42:58
ABCDEFGHIJ 10/24/2018 16:43:0
ABCDEFGHIJ 10/24/2018 16:43:2
ABCDEFGHIJ 10/24/2018 16:43:4
ABCDEFGHIJ 10/24/2018 16:43:6
ABCDEFGHIJ 10/24/2018 16:43:8
ABCDEFGHIJ 10/24/2018 16:43:10
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
