sand0636/RFID/RFID-Network-Build-master/tests/Reads transfered sucessfully/Analyse Reads/10-24-18-2/TESTDATA.TXT

ABCDEFGHIJ 10/26/2018 0:1:55
ABCDEFGHIJ 10/26/2018 0:1:57
ABCDEFGHIJ 10/26/2018 0:1:59
ABCDEFGHIJ 10/26/2018 0:2:1
ABCDEFGHIJ 10/26/2018 0:2:3
ABCDEFGHIJ 10/26/2018 0:2:5
ABCDEFGHIJ 10/26/2018 0:2:7
ABCDEFGHIJ 10/26/2018 0:2:9
ABCDEFGHIJ 10/26/2018 0:2:11
ABCDEFGHIJ 10/26/2018 0:2:13
ABCDEFGHIJ 10/26/2018 0:2:15
ABCDEFGHIJ 10/26/2018 0:2:17
ABCDEFGHIJ 10/26/2018 0:2:19
ABCDEFGHIJ 10/26/2018 0:2:21
ABCDEFGHIJ 10/26/2018 0:2:23
ABCDEFGHIJ 10/26/2018 0:2:25
ABCDEFGHIJ 10/26/2018 0:2:27
ABCDEFGHIJ 10/26/2018 0:2:29
ABCDEFGHIJ 10/26/2018 0:2:31
ABCDEFGHIJ 10/26/2018 0:2:33
ABCDEFGHIJ 10/26/2018 0:2:35
ABCDEFGHIJ 10/26/2018 0:2:37
ABCDEFGHIJ 10/26/2018 0:2:39
ABCDEFGHIJ 10/26/2018 0:2:41
ABCDEFGHIJ 10/26/2018 0:2:43
ABCDEFGHIJ 10/26/2018 0:2:45
ABCDEFGHIJ 10/26/2018 0:2:47
ABCDEFGHIJ 10/26/2018 0:2:49
ABCDEFGHIJ 10/26/2018 0:2:51
ABCDEFGHIJ 10/26/2018 0:2:53
ABCDEFGHIJ 10/26/2018 0:2:55
ABCDEFGHIJ 10/26/2018 0:2:57
ABCDEFGHIJ 10/26/2018 0:2:59
ABCDEFGHIJ 10/26/2018 0:3:1
ABCDEFGHIJ 10/26/2018 0:3:3
ABCDEFGHIJ 10/26/2018 0:3:5
ABCDEFGHIJ 10/26/2018 0:3:7
ABCDEFGHIJ 10/26/2018 0:3:9
ABCDEFGHIJ 10/26/2018 0:3:11
ABCDEFGHIJ 10/26/2018 0:3:13
ABCDEFGHIJ 10/26/2018 0:3:15
ABCDEFGHIJ 10/26/2018 0:3:17
ABCDEFGHIJ 10/26/2018 0:3:19
ABCDEFGHIJ 10/26/2018 0:3:21
ABCDEFGHIJ 10/26/2018 0:3:23
ABCDEFGHIJ 10/26/2018 0:3:25
ABCDEFGHIJ 10/26/2018 0:3:27
ABCDEFGHIJ 10/26/2018 0:3:29
ABCDEFGHIJ 10/26/2018 0:3:31
ABCDEFGHIJ 10/26/2018 0:3:33
ABCDEFGHIJ 10/26/2018 0:3:35
ABCDEFGHIJ 10/26/2018 0:3:37
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
ABCDEFGHIJ 10/26/2018 0:13:15
ABCDEFGHIJ 10/26/2018 0:13:17
ABCDEFGHIJ 10/26/2018 0:13:19
ABCDEFGHIJ 10/26/2018 0:13:21
ABCDEFGHIJ 10/26/2018 0:13:23
ABCDEFGHIJ 10/26/2018 0:13:25
ABCDEFGHIJ 10/26/2018 0:13:27
ABCDEFGHIJ 10/26/2018 0:13:29
ABCDEFGHIJ 10/26/2018 0:13:31
