sand0636/RFID/RFID-Network-Build-master/tests/Reads transfered sucessfully/Analyse Reads/10-24-18-3/TESTDATA.TXT

ABCDEFGHIJ 10/26/2018 2:17:29
ABCDEFGHIJ 10/26/2018 2:17:31
ABCDEFGHIJ 10/26/2018 2:17:33
ABCDEFGHIJ 10/26/2018 2:17:35
ABCDEFGHIJ 10/26/2018 2:17:37
ABCDEFGHIJ 10/26/2018 2:17:39
ABCDEFGHIJ 10/26/2018 2:17:41
ABCDEFGHIJ 10/26/2018 2:17:43
ABCDEFGHIJ 10/26/2018 2:17:45
ABCDEFGHIJ 10/26/2018 2:17:47
ABCDEFGHIJ 10/26/2018 2:17:49
ABCDEFGHIJ 10/26/2018 2:17:51
ABCDEFGHIJ 10/26/2018 2:17:53
ABCDEFGHIJ 10/26/2018 2:17:55
ABCDEFGHIJ 10/26/2018 2:17:57
ABCDEFGHIJ 10/26/2018 2:17:59
ABCDEFGHIJ 10/26/2018 2:18:1
ABCDEFGHIJ 10/26/2018 2:18:3
ABCDEFGHIJ 10/26/2018 2:18:5
ABCDEFGHIJ 10/26/2018 2:18:7
ABCDEFGHIJ 10/26/2018 2:18:9
ABCDEFGHIJ 10/26/2018 2:18:11
ABCDEFGHIJ 10/26/2018 2:18:13
ABCDEFGHIJ 10/26/2018 2:18:15
ABCDEFGHIJ 10/26/2018 2:18:17
ABCDEFGHIJ 10/26/2018 2:18:19
ABCDEFGHIJ 10/26/2018 2:18:21
ABCDEFGHIJ 10/26/2018 2:18:23
ABCDEFGHIJ 10/26/2018 2:18:25
ABCDEFGHIJ 10/26/2018 2:18:27
ABCDEFGHIJ 10/26/2018 2:18:29
ABCDEFGHIJ 10/26/2018 2:18:31
ABCDEFGHIJ 10/26/2018 2:18:33
ABCDEFGHIJ 10/26/2018 2:18:35
ABCDEFGHIJ 10/26/2018 2:18:37
ABCDEFGHIJ 10/26/2018 2:18:39
ABCDEFGHIJ 10/26/2018 2:18:41
ABCDEFGHIJ 10/26/2018 2:18:43
ABCDEFGHIJ 10/26/2018 2:18:45
ABCDEFGHIJ 10/26/2018 2:18:47
ABCDEFGHIJ 10/26/2018 2:18:49
ABCDEFGHIJ 10/26/2018 2:18:51
ABCDEFGHIJ 10/26/2018 2:18:53
ABCDEFGHIJ 10/26/2018 2:18:55
ABCDEFGHIJ 10/26/2018 2:18:57
ABCDEFGHIJ 10/26/2018 2:18:59
ABCDEFGHIJ 10/26/2018 2:19:1
ABCDEFGHIJ 10/26/2018 2:19:3
ABCDEFGHIJ 10/26/2018 2:19:5
ABCDEFGHIJ 10/26/2018 2:19:7
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
ABCDEFGHIJ 10/26/2018 2:33:49
ABCDEFGHIJ 10/26/2018 2:33:51
ABCDEFGHIJ 10/26/2018 2:33:53
ABCDEFGHIJ 10/26/2018 2:33:55
ABCDEFGHIJ 10/26/2018 2:33:57
ABCDEFGHIJ 10/26/2018 2:33:59
ABCDEFGHIJ 10/26/2018 2:34:1
ABCDEFGHIJ 10/26/2018 2:34:3
ABCDEFGHIJ 10/26/2018 2:34:5
ABCDEFGHIJ 10/26/2018 2:34:7
ABCDEFGHIJ 10/26/2018 2:34:9
ABCDEFGHIJ 10/26/2018 2:34:11
ABCDEFGHIJ 10/26/2018 2:34:13
ABCDEFGHIJ 10/26/2018 2:34:15
