sand0636/RFID/RFID-Network-Build-master/tests/Reads transfered sucessfully/Analyse Reads/10-24-18-4/0006NOTE.TXT

0006NOTE
LOGGING STARTED: 02/10/00 06:24:50
LOGGING STARTED: 02/10/00 13:19:12
