sand0636/RFID/RFID-Network-Build-master/tests/Reads transfered sucessfully/Analyse Reads/10-24-18-4/TESTDATA.TXT

ABCDEFGHIJ 10/26/2018 4:57:43
ABCDEFGHIJ 10/26/2018 4:57:58
ABCDEFGHIJ 10/26/2018 4:58:0
ABCDEFGHIJ 10/26/2018 4:58:2
ABCDEFGHIJ 10/26/2018 4:58:4
ABCDEFGHIJ 10/26/2018 4:58:6
ABCDEFGHIJ 10/26/2018 4:58:8
ABCDEFGHIJ 10/26/2018 4:58:10
ABCDEFGHIJ 10/26/2018 4:58:12
ABCDEFGHIJ 10/26/2018 4:58:14
ABCDEFGHIJ 10/26/2018 4:58:16
ABCDEFGHIJ 10/26/2018 4:58:18
ABCDEFGHIJ 10/26/2018 4:58:20
ABCDEFGHIJ 10/26/2018 4:58:22
ABCDEFGHIJ 10/26/2018 4:58:24
ABCDEFGHIJ 10/26/2018 4:58:26
ABCDEFGHIJ 10/26/2018 4:58:28
ABCDEFGHIJ 10/26/2018 4:58:30
ABCDEFGHIJ 10/26/2018 4:58:32
ABCDEFGHIJ 10/26/2018 4:58:34
ABCDEFGHIJ 10/26/2018 4:58:36
ABCDEFGHIJ 10/26/2018 4:58:38
ABCDEFGHIJ 10/26/2018 4:58:40
ABCDEFGHIJ 10/26/2018 4:58:42
ABCDEFGHIJ 10/26/2018 4:58:44
ABCDEFGHIJ 10/26/2018 4:58:46
ABCDEFGHIJ 10/26/2018 4:58:48
ABCDEFGHIJ 10/26/2018 4:58:50
ABCDEFGHIJ 10/26/2018 4:58:52
ABCDEFGHIJ 10/26/2018 4:58:54
ABCDEFGHIJ 10/26/2018 4:58:56
ABCDEFGHIJ 10/26/2018 4:58:58
ABCDEFGHIJ 10/26/2018 4:59:0
ABCDEFGHIJ 10/26/2018 4:59:2
ABCDEFGHIJ 10/26/2018 4:59:4
ABCDEFGHIJ 10/26/2018 4:59:6
ABCDEFGHIJ 10/26/2018 4:59:8
ABCDEFGHIJ 10/26/2018 4:59:10
ABCDEFGHIJ 10/26/2018 4:59:12
ABCDEFGHIJ 10/26/2018 4:59:14
ABCDEFGHIJ 10/26/2018 4:59:16
ABCDEFGHIJ 10/26/2018 4:59:18
ABCDEFGHIJ 10/26/2018 4:59:20
ABCDEFGHIJ 10/26/2018 4:59:22
ABCDEFGHIJ 10/26/2018 4:59:24
ABCDEFGHIJ 10/26/2018 4:59:26
ABCDEFGHIJ 10/26/2018 4:59:28
ABCDEFGHIJ 10/26/2018 4:59:30
ABCDEFGHIJ 10/26/2018 4:59:32
ABCDEFGHIJ 10/26/2018 4:59:34
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
ABCDEFGHIJ 10/26/2018 5:53:58
ABCDEFGHIJ 10/26/2018 5:54:0
ABCDEFGHIJ 10/26/2018 5:54:2
ABCDEFGHIJ 10/26/2018 5:54:4
ABCDEFGHIJ 10/26/2018 5:54:6
ABCDEFGHIJ 10/26/2018 5:54:8
ABCDEFGHIJ 10/26/2018 5:54:10
ABCDEFGHIJ 10/26/2018 5:54:12
ABCDEFGHIJ 10/26/2018 5:54:14
ABCDEFGHIJ 10/26/2018 5:54:16
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
