sand0636/RFID/RFID-Network-Build-master/other/board/ETAG_v9.3b_EM4095.brd

## EAGLE design RFID-Network-Build-master/other/board/ETAG_v9.3b_EM4095.brd (2019-05-10)

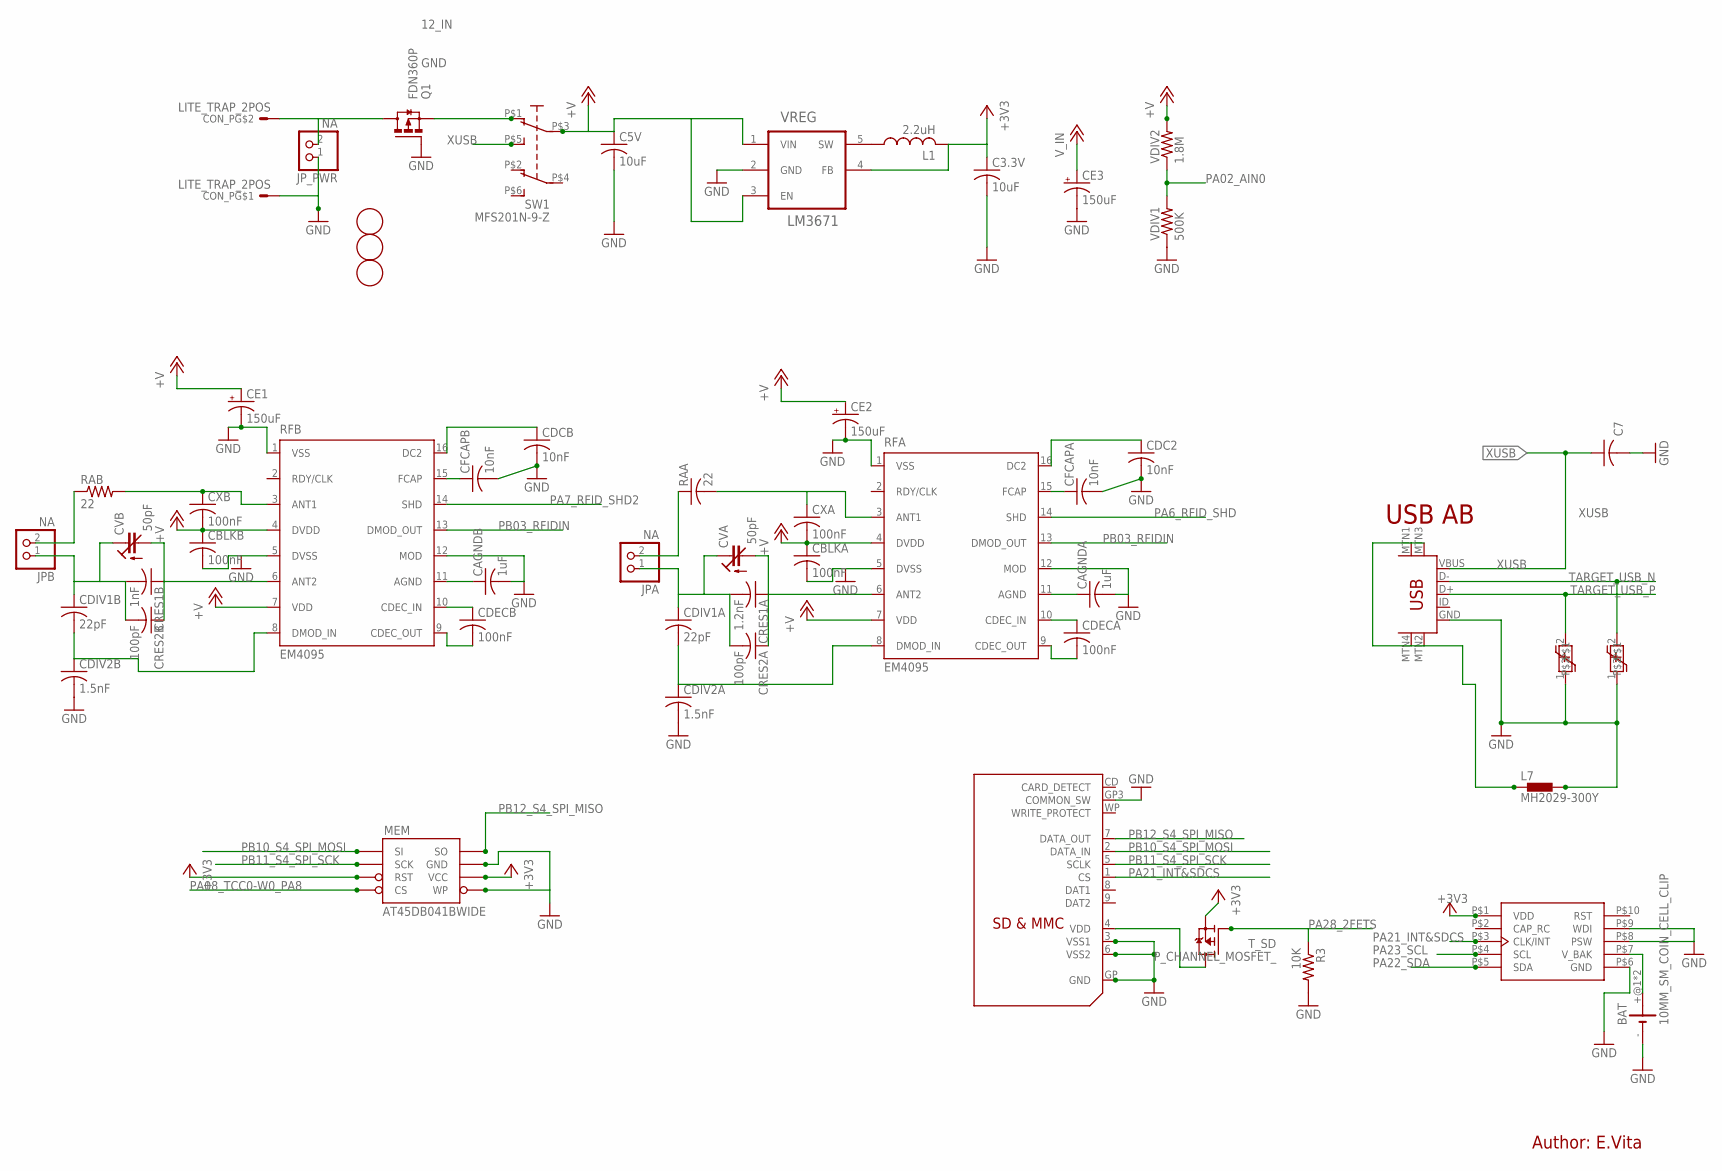
[picture p34: schematic ETAG_v9.3b_EM4095.sch, sheet 1]

Parts:
BAT: 10MM_SM_COIN_CELL_CLIP
C3.3V, C5V: 10uF; C0805
C7: 10nF; C0603-ROUND
CAGNDA: 1uF; C0603-ROUND
CAGNDB: 1uF; C0603-ROUND
CBLKA: 100nF; C0603-ROUND
CBLKB: 100nF; C0603-ROUND
CDC2: 10nF; C0603-ROUND
CDCB: 10nF; C0603-ROUND
CDECA: 100nF; C0603-ROUND
CDECB: 100nF; C0603-ROUND
CDIV1A, CDIV1B: 22pF; C0603-ROUND
CDIV2A, CDIV2B: 1.5nF; C0603-ROUND
CE1, CE2, CE3: 150uF; E2-5
CFCAPA: 10nF; C0603-ROUND
CFCAPB: 10nF; C0603-ROUND
CON_P: LITE_TRAP_2POS; LITE_TRAP_MINI
CRES1A: 1.2nF; C0603-ROUND
CRES1B: 1nF; C0603-ROUND
CRES2A, CRES2B: 100pF; C0603-ROUND
CVA: 50pF; CTRIM3018_11
CVB: 50pF; CTRIM3018_11
CXA: 100nF; C0603-ROUND
CXB: 100nF; C0603-ROUND
FD1, FD2, FD3: FIDUCIALMOUNT; FIDUCIA-MOUNT
JPA: NA; 1X02
JPB: NA; 1X02
JP_PWR: NA; 1X02
L1: 2.2uH; SMT_COIL_INDUCTOR_4X4MM
L7: MH2029-300Y; C0805K
MEM: AT45DB041BWIDE; SO08WIDE
Q1: FDN360P; SUPER-SOT3
R3: 10K; C0603-ROUND
RAA: 22; C0805
RAB: 22; R0805
RFA: EM4095; SO16
RFB: EM4095; SO16
RTC: MC-RTC-RV-1805-C3-I2C; MC-RTC-C3
SD: SDMMC06132; 06132
SW1: MFS201N-9-Z
T_SD: P_CHANNEL_MOSFET_; SOT23
USB: USB-MINIB-5PIN; USB-MINIB
VDIV1: 500K; C0603-ROUND
VDIV2: 1.8M; C0603-ROUND
VREG: LM3671; SOT23-5L
Z5, Z6: ESD_SUPRESSOR; C0603-ROUND

Connections:
2GND: L7.1, USB.MTN1 (MTN2), USB.MTN2 (MTN3), USB.MTN3 (MTN1), USB.MTN4
12_IN: CON_P.P$3, CON_P.P$4, JP_PWR.2, Q1.3 (D)
+3V3: C3.3V.1, L1.P$2 (2), MEM.3 (RST), MEM.6 (VCC), RTC.P$1 (VDD), T_SD.2 (S), VREG.4 (FB); also elsewhere on the board
CVB: CDIV1B.1, CRES1B.2, CRES2B.2, CVB.+ (E), JPB.1
GND: BAT.-, C3.3V.2, C5V.2, C7.2, CAGNDA.2, CAGNDB.2, CBLKA.2, CBLKB.2, CDC2.2, CDCB.2, CDIV2A.2, CDIV2B.2, CE1.-, CE2.-, CE3.-, CFCAPA.2, CFCAPB.2, CON_P.P$1, CON_P.P$2, JP_PWR.1, L7.2, MEM.5 (WP), MEM.7 (GND), Q1.1 (G), R3.2, RFA.1 (VSS), RFA.5 (DVSS), RFA.12 (MOD), RFB.1 (VSS), RFB.5 (DVSS), RFB.12 (MOD), RTC.P$6 (GND), RTC.P$8 (PSW), RTC.P$9 (WDI), SD.3 (VSS1), SD.6 (VSS2), SD.GP (GND), SD.GP3 (COMMON_SW), USB.GND, VDIV1.1, VREG.2 (GND), Z5.1, Z6.1; also elsewhere on the board
unnamed: CFCAPB.1, RFB.15 (FCAP)
unnamed: CAGNDB.1, RFB.11 (AGND)
unnamed: CFCAPA.1, RFA.15 (FCAP)
unnamed: CAGNDA.1, RFA.11 (AGND)
unnamed: CDC2.1, RFA.16 (DC2)
unnamed: CRES1B.1, CRES2B.1, CVB.- (A), RFB.6 (ANT2)
unnamed: CDIV1B.2, CDIV2B.1, RFB.8 (DMOD_IN)
unnamed: CDCB.1, RFB.16 (DC2)
unnamed: CDECB.2, RFB.9 (CDEC_OUT)
unnamed: CRES1A.1, CRES2A.1, CVA.- (A), RFA.6 (ANT2)
unnamed: CDIV1A.2, CDIV2A.1, RFA.8 (DMOD_IN)
unnamed: CDIV1A.1, CRES1A.2, CRES2A.2, CVA.+ (E), JPA.1
unnamed: CDECB.1, RFB.10 (CDEC_IN)
unnamed: CXB.1, RAB.2, RFB.3 (ANT1)
unnamed: Q1.2 (S), SW1.P$1 (O)
unnamed: CDECA.2, RFA.9 (CDEC_OUT)
unnamed: CDECA.1, RFA.10 (CDEC_IN)
unnamed: CXA.1, RAA.2, RFA.3 (ANT1)
unnamed: JPB.2, RAB.1
unnamed: JPA.2, RAA.1
PA02_AIN0: VDIV1.2, VDIV2.1; also elsewhere on the board
PA6_RFID_SHD: RFA.14 (SHD); also elsewhere on the board
PA7_RFID_SHD2: RFB.14 (SHD); also elsewhere on the board
PA08_TCC0-W0_PA8: MEM.4 (CS); also elsewhere on the board
PA21_INT&SDCS: RTC.P$3 (CLK/INT), SD.1 (CS); also elsewhere on the board
PA22_SDA: RTC.P$5 (SDA); also elsewhere on the board
PA23_SCL: RTC.P$4 (SCL); also elsewhere on the board
PA28_2FETS: R3.1, T_SD.1 (G); also elsewhere on the board
PB03_RFIDIN: RFA.13 (DMOD_OUT), RFB.13 (DMOD_OUT); also elsewhere on the board
PB10_S4_SPI_MOSI: MEM.1 (SI), SD.2 (DATA_IN); also elsewhere on the board
PB11_S4_SPI_SCK: MEM.2 (SCK), SD.5 (SCLK); also elsewhere on the board
PB12_S4_SPI_MISO: MEM.8 (SO), SD.7 (DATA_OUT); also elsewhere on the board
SW: L1.P$1 (1), VREG.5 (SW)
TARGET_USB_N: USB.D-, Z6.2; also elsewhere on the board
TARGET_USB_P: USB.D+, Z5.2; also elsewhere on the board
VBAT1: BAT.+@1 (+), BAT.+@2 (+), RTC.P$7 (V_BAK)
VDD: SD.4 (VDD), T_SD.3 (D)
V_IN: C5V.1, CBLKA.1, CBLKB.1, CE1.+, CE2.+, CE3.+, CXA.2, CXB.2, RFA.4 (DVDD), RFA.7 (VDD), RFB.4 (DVDD), RFB.7 (VDD), SW1.P$3, VDIV2.2, VREG.1 (VIN), VREG.3 (EN); also elsewhere on the board
XUSB: C7.1, SW1.P$5 (S), USB.VBUS

Notes on the sheet:
USB AB
Author: E.Vita

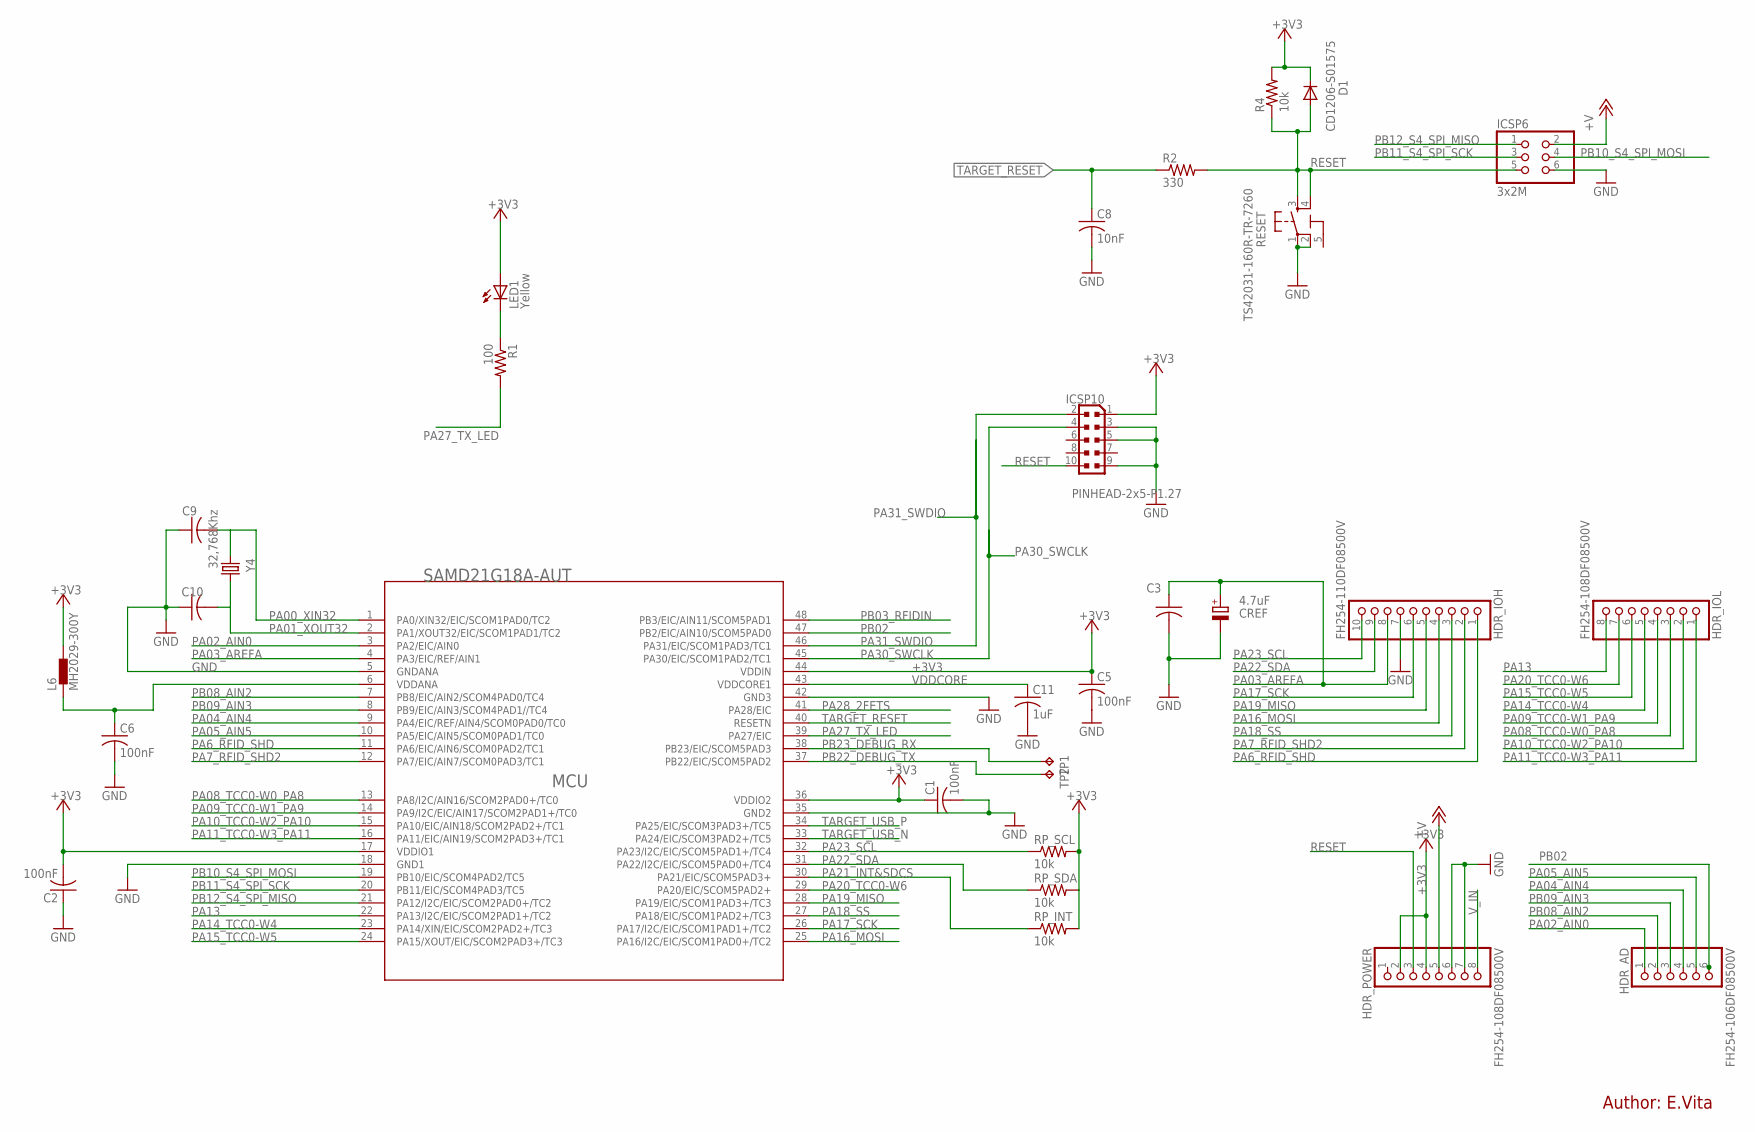
[picture p35: schematic ETAG_v9.3b_EM4095.sch, sheet 2]

Parts:
C1, C2, C3, C5, C6: 100nF; C0603-ROUND
C8: 10nF; C0603-ROUND
C9, C10: 22pF; C0603-ROUND
C11: 1uF; C0603-ROUND
CREF: 4.7uF; SMC_A
D1: CD1206-S01575; MINIMELF
HDR_AD: FH254-106DF08500V; 1X06
HDR_IOH: FH254-110DF08500V; 1X10
HDR_IOL: FH254-108DF08500V; 1X08
HDR_POWER: FH254-108DF08500V; 1X08
ICSP6: 3x2M; 2X03
ICSP10: PINHEAD-2x5-P1.27; PINHEAD_2X05_127
L6: MH2029-300Y; C0805K
LED1: Yellow; CHIPLED_0805
MCU: SAMD21G18A-AUT; TQFP48-7X7
R1: 100; C0603-ROUND
R2: 330; C0603-ROUND
R4: 10k; C0603-ROUND
RESET: TS42031-160R-TR-7260; TS42
RP_INT: 10k; C0603-ROUND
RP_SCL: 10k; C0603-ROUND
RP_SDA: 10k; C0603-ROUND
TP1, TP2: TPTP15R; TP15R
Y4: 32,768Khz; RESONATOR_EPSON_FC_145

Connections:
5-GND: RESET.5 (5-GND)
+3V3: C1.1, C2.2, C5.1, D1.C, HDR_POWER.2, HDR_POWER.4, ICSP10.1, L6.2, LED1.A, MCU.17 (VDDIO1), MCU.36 (VDDIO2), MCU.44 (VDDIN), R4.2, RP_INT.2, RP_SCL.2, RP_SDA.2; also elsewhere on the board
GND: C1.2, C2.1, C3.2, C5.2, C6.2, C8.2, C9.1, C10.1, C11.2, CREF.-, HDR_IOH.7, HDR_POWER.6, HDR_POWER.7, ICSP6.6, ICSP10.3, ICSP10.5, ICSP10.9, MCU.5 (GNDANA), MCU.18 (GND1), MCU.35 (GND2), MCU.42 (GND3), RESET.1, RESET.2; also elsewhere on the board
unnamed: LED1.C, R1.1
unnamed: C6.1, L6.1, MCU.6 (VDDANA)
PA00_XIN32: C9.2, MCU.1 (PA0/XIN32/EIC/SCOM1PAD0/TC2), Y4.P$1 (1)
PA01_XOUT32: C10.2, MCU.2 (PA1/XOUT32/EIC/SCOM1PAD1/TC2), Y4.P$2 (2)
PA02_AIN0: HDR_AD.1, MCU.3 (PA2/EIC/AIN0); also elsewhere on the board
PA03_AREFA: C3.1, CREF.+, HDR_IOH.8, MCU.4 (PA3/EIC/REF/AIN1)
PA04_AIN4: HDR_AD.4, MCU.9 (PA4/EIC/REF/AIN4/SCOM0PAD0/TC0)
PA05_AIN5: HDR_AD.5, MCU.10 (PA5/EIC/AIN5/SCOM0PAD1/TC0)
PA6_RFID_SHD: HDR_IOH.1, MCU.11 (PA6/EIC/AIN6/SCOM0PAD2/TC1); also elsewhere on the board
PA7_RFID_SHD2: HDR_IOH.2, MCU.12 (PA7/EIC/AIN7/SCOM0PAD3/TC1); also elsewhere on the board
PA08_TCC0-W0_PA8: HDR_IOL.3, MCU.13 (PA8/I2C/AIN16/SCOM2PAD0+/TC0); also elsewhere on the board
PA09_TCC0-W1_PA9: HDR_IOL.4, MCU.14 (PA9/I2C/EIC/AIN17/SCOM2PAD1+/TC0)
PA10_TCC0-W2_PA10: HDR_IOL.2, MCU.15 (PA10/EIC/AIN18/SCOM2PAD2+/TC1)
PA11_TCC0-W3_PA11: HDR_IOL.1, MCU.16 (PA11/EIC/AIN19/SCOM2PAD3+/TC1)
PA13: HDR_IOL.8, MCU.22 (PA13/I2C/EIC/SCOM2PAD1+/TC2)
PA14_TCC0-W4: HDR_IOL.5, MCU.23 (PA14/XIN/EIC/SCOM2PAD2+/TC3)
PA15_TCC0-W5: HDR_IOL.6, MCU.24 (PA15/XOUT/EIC/SCOM2PAD3+/TC3)
PA16_MOSI: HDR_IOH.4, MCU.25 (PA16/I2C/EIC/SCOM1PAD0+/TC2)
PA17_SCK: HDR_IOH.6, MCU.26 (PA17/I2C/EIC/SCOM1PAD1+/TC2)
PA18_SS: HDR_IOH.3, MCU.27 (PA18/EIC/SCOM1PAD2+/TC3)
PA19_MISO: HDR_IOH.5, MCU.28 (PA19/EIC/SCOM1PAD3+/TC3)
PA20_TCC0-W6: HDR_IOL.7, MCU.29 (PA20/EIC/SCOM5PAD2+)
PA21_INT&SDCS: MCU.30 (PA21/EIC/SCOM5PAD3+), RP_INT.1; also elsewhere on the board
PA22_SDA: HDR_IOH.9, MCU.31 (PA22/I2C/EIC/SCOM5PAD0+/TC4), RP_SDA.1; also elsewhere on the board
PA23_SCL: HDR_IOH.10, MCU.32 (PA23/I2C/EIC/SCOM5PAD1+/TC4), RP_SCL.1; also elsewhere on the board
PA27_TX_LED: MCU.39 (PA27/EIC), R1.2
PA28_2FETS: MCU.41 (PA28/EIC); also elsewhere on the board
PA30_SWCLK: ICSP10.4, MCU.45 (PA30/EIC/SCOM1PAD2/TC1)
PA31_SWDIO: ICSP10.2, MCU.46 (PA31/EIC/SCOM1PAD3/TC1)
PB02: HDR_AD.6, MCU.47 (PB2/EIC/AIN10/SCOM5PAD0)
PB03_RFIDIN: MCU.48 (PB3/EIC/AIN11/SCOM5PAD1); also elsewhere on the board
PB08_AIN2: HDR_AD.2, MCU.7 (PB8/EIC/AIN2/SCOM4PAD0/TC4)
PB09_AIN3: HDR_AD.3, MCU.8 (PB9/EIC/AIN3/SCOM4PAD1//TC4)
PB10_S4_SPI_MOSI: ICSP6.4, MCU.19 (PB10/EIC/SCOM4PAD2/TC5); also elsewhere on the board
PB11_S4_SPI_SCK: ICSP6.3, MCU.20 (PB11/EIC/SCOM4PAD3/TC5); also elsewhere on the board
PB12_S4_SPI_MISO: ICSP6.1, MCU.21 (PA12/I2C/EIC/SCOM2PAD0+/TC2); also elsewhere on the board
PB22_DEBUG_TX: MCU.37 (PB22/EIC/SCOM5PAD2), TP2.TP
PB23_DEBUG_RX: MCU.38 (PB23/EIC/SCOM5PAD3), TP1.TP
RESET: D1.A, HDR_POWER.3, ICSP6.5, ICSP10.10, R2.2, R4.1, RESET.3, RESET.4
TARGET_RESET: C8.1, MCU.40 (RESETN), R2.1
TARGET_USB_N: MCU.33 (PA24/EIC/SCOM3PAD2+/TC5); also elsewhere on the board
TARGET_USB_P: MCU.34 (PA25/EIC/SCOM3PAD3+/TC5); also elsewhere on the board
VDDCORE: C11.1, MCU.43 (VDDCORE1)
V_IN: HDR_POWER.5, HDR_POWER.8, ICSP6.2; also elsewhere on the board

Notes on the sheet:
Author: E.Vita

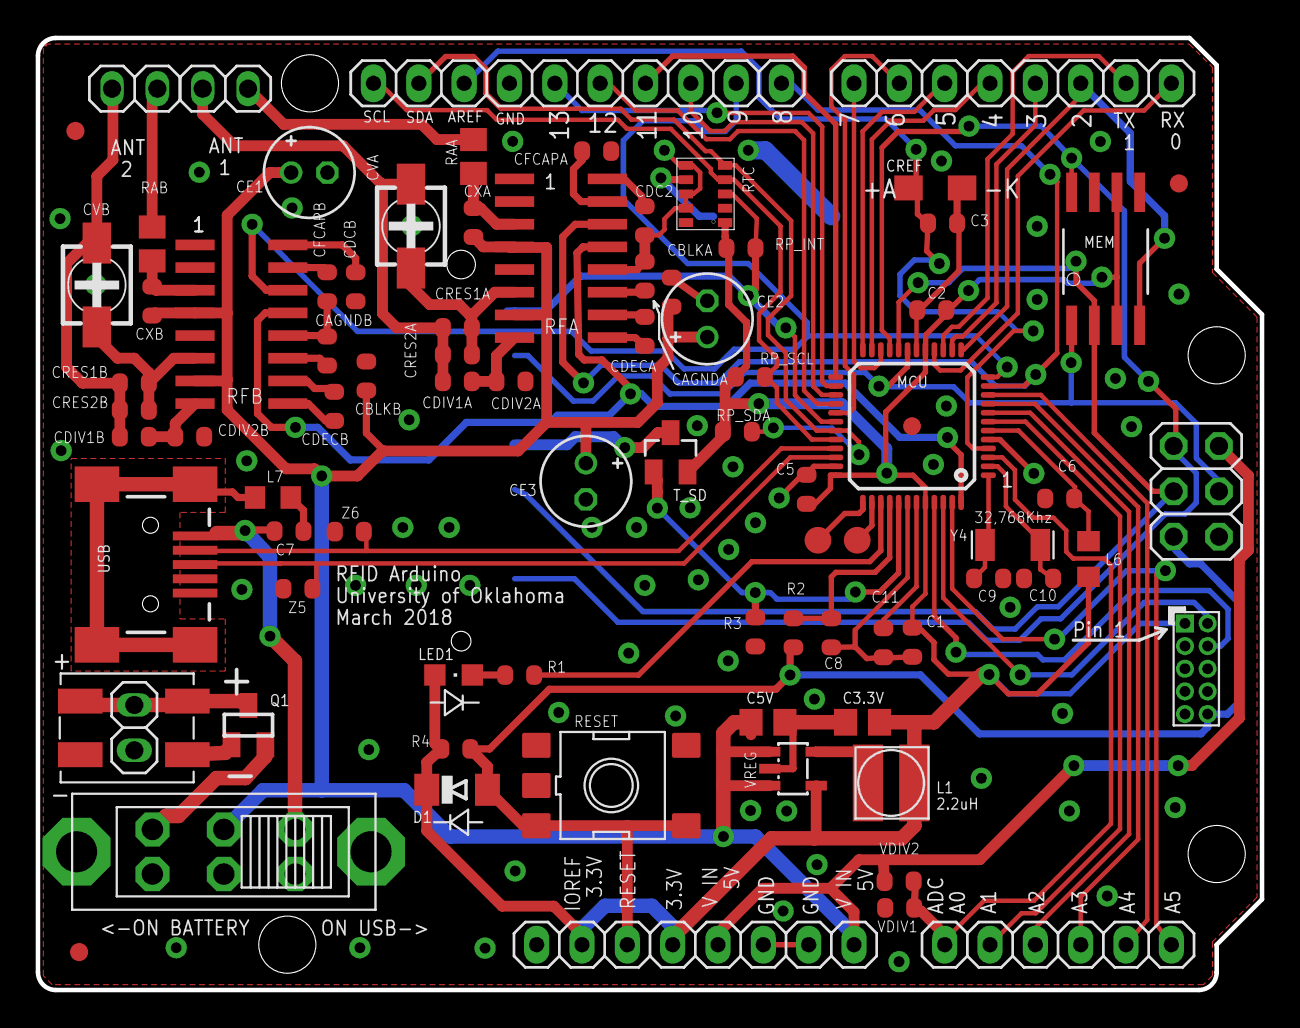
[picture p36: board ETAG_v9.3b_EM4095.brd from above]

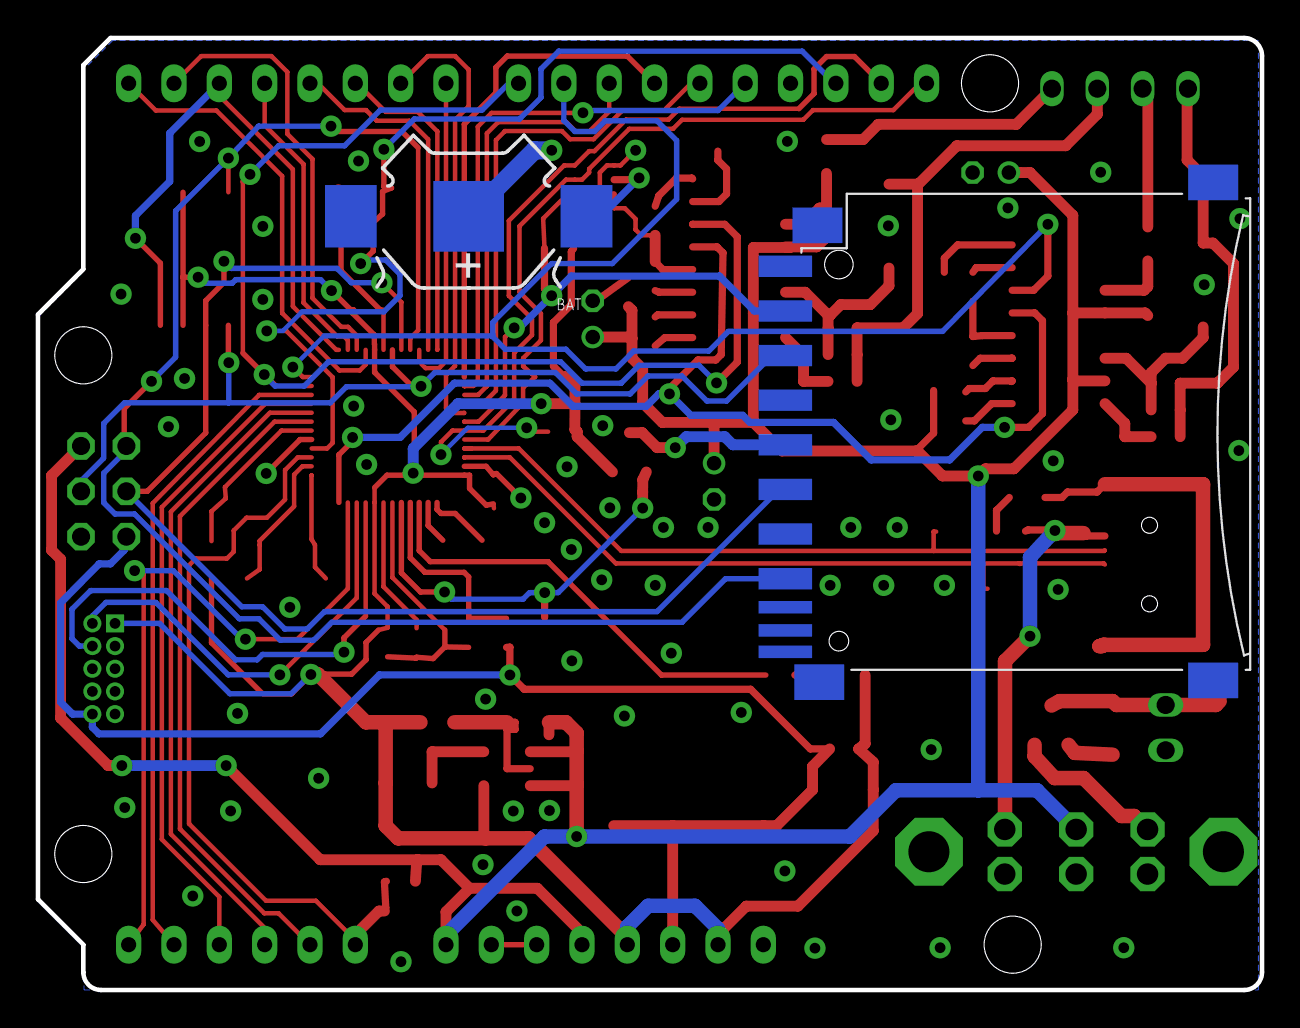
[picture p37: board ETAG_v9.3b_EM4095.brd from below]

Board: 4 copper layers, 68.6 x 53.3 mm, 85 parts (2 on the bottom side), 73 nets.
