sand0636/RFID/RFID-Network-Build-master/arduino/Other programs/RFIDNetworkETagSleep/RF24Network_config.h

/*
 Copyright (C) 2011 James Coliz, Jr. <maniacbug@ymail.com>

 This program is free software; you can redistribute it and/or
 modify it under the terms of the GNU General Public License
 version 2 as published by the Free Software Foundation.
 */


#ifndef __RF24NETWORK_CONFIG_H__
#define __RF24NETWORK_CONFIG_H__

#define NETWORK_DEFAULT_ADDRESS 04444

  #if !defined(__AVR_ATtiny85__) && !defined(__AVR_ATtiny84__)

    /********** USER CONFIG - non ATTiny **************/

    //#define DUAL_HEAD_RADIO
    //#define ENABLE_SLEEP_MODE  //AVR only
    #define RF24NetworkMulticast

    /** \def
	 * Saves memory by disabling fragmentation
	 */
    //#define DISABLE_FRAGMENTATION 

    /** System defines */

    /** The size of the main buffer. This is the user-cache, where incoming data is stored.
     * Data is stored using Frames: Header (8-bytes) + Frame_Size (2-bytes) + Data (?-bytes)
     * 
     * @note The MAX_PAYLOAD_SIZE is (MAIN_BUFFER_SIZE - 10), and the result must be divisible by 24.
     */
    #define MAIN_BUFFER_SIZE 144 + 10

    /** Maximum size of fragmented network frames and fragmentation cache. This MUST BE divisible by 24.
    * @note: Must be a multiple of 24.
    * @note: If used with RF24Ethernet, this value is used to set the buffer sizes.
    */
    #define MAX_PAYLOAD_SIZE  MAIN_BUFFER_SIZE-10

    /** Disable user payloads. Saves memory when used with RF24Ethernet or software that uses external data.*/
    //#define DISABLE_USER_PAYLOADS 

    /** Enable tracking of success and failures for all transmissions, routed and user initiated */
    //#define ENABLE_NETWORK_STATS
    
    /** Enable dynamic payloads - If using different types of NRF24L01 modules, some may be incompatible when using this feature **/
    #define ENABLE_DYNAMIC_PAYLOADS

    /** Debug Options */
    //#define SERIAL_DEBUG
    //#define SERIAL_DEBUG_MINIMAL
    //#define SERIAL_DEBUG_ROUTING
    //#define SERIAL_DEBUG_FRAGMENTATION
    //#define SERIAL_DEBUG_FRAGMENTATION_L2
    /*************************************/
 
  #else // Different set of defaults for ATTiny - fragmentation is disabled and user payloads are set to 3 max
    /********** USER CONFIG - ATTiny **************/
    //#define DUAL_HEAD_RADIO
    //#define ENABLE_SLEEP_MODE  //AVR only
    #define RF24NetworkMulticast
    #define MAIN_BUFFER_SIZE 96 + 10
    #define DISABLE_FRAGMENTATION
    // Enable MAX PAYLOAD SIZE if enabling fragmentation
    //#define MAX_PAYLOAD_SIZE  MAIN_BUFFER_SIZE-10
    #define ENABLE_DYNAMIC_PAYLOADS
    //#define DISABLE_USER_PAYLOADS 
  #endif
  /*************************************/


#endif //RF24_NETWORK_CONFIG_H

#ifdef __cplusplus

#if (defined (__linux) || defined (linux)) && !defined (__ARDUINO_X86__)
    #include <RF24/RF24_config.h>
	
//ATXMega
#elif defined(XMEGA)
	#include "../../rf24lib/rf24lib/RF24_config.h"
#else
    #include "RF24_config.h"
#endif

  #if !defined (ARDUINO_ARCH_AVR)
    #define sprintf_P sprintf    
  #endif
  
    #if defined (SERIAL_DEBUG_MINIMAL)
      #define IF_SERIAL_DEBUG_MINIMAL(x) ({x;})
    #else
      #define IF_SERIAL_DEBUG_MINIMAL(x)
    #endif
  
    #if defined (SERIAL_DEBUG_FRAGMENTATION)
      #define IF_SERIAL_DEBUG_FRAGMENTATION(x) ({x;})
    #else
      #define IF_SERIAL_DEBUG_FRAGMENTATION(x)
    #endif

    #if defined (SERIAL_DEBUG_FRAGMENTATION_L2)
      #define IF_SERIAL_DEBUG_FRAGMENTATION_L2(x) ({x;})
    #else
      #define IF_SERIAL_DEBUG_FRAGMENTATION_L2(x)
    #endif
  
    #if defined (SERIAL_DEBUG_ROUTING)
      #define IF_SERIAL_DEBUG_ROUTING(x) ({x;})
    #else
      #define IF_SERIAL_DEBUG_ROUTING(x)
    #endif
    

#endif //RF24_CONFIG_H
