sand0636/RFID/RFID-Network-Build-master/arduino/Individual components/nrf24 examples/RF24Mesh_Example/RF24Mesh_Example.ino

/** RF24Mesh_Example.ino by TMRh20

   This example sketch shows how to manually configure a node via RF24Mesh, and send data to the
   master node.
   The nodes will refresh their network address as soon as a single write fails. This allows the
   nodes to change position in relation to each other and the master node.
*/


#include "RF24.h"
#include "RF24Network.h"
#include "RF24Mesh.h"
#include <SPI.h>
//#include <printf.h>

#define serial SerialUSB

/**** Configure the nrf24l01 CE and CS pins ****/
RF24 radio(2, 3);
RF24Network network(radio);
RF24Mesh mesh(radio, network);

/**
   User Configuration: nodeID - A unique identifier for each radio. Allows addressing
   to change dynamically with physical changes to the mesh.

   In this example, configuration takes place below, prior to uploading the sketch to the device
   A unique value from 1-255 must be configured for each node.
   This will be stored in EEPROM on AVR devices, so remains persistent between further uploads, loss of power, etc.

 **/
#define nodeID 1


unsigned long displayTimer = 0;

struct payload_t {
  unsigned long ms;
  unsigned long counter;
};

void setup() {

  serial.begin(115200);
  //printf_begin();
  // Set the nodeID manually
  mesh.setNodeID(nodeID);
  // Connect to the mesh
  serial.println(F("Connecting to the mesh..."));
  mesh.begin(90);
}



void loop() {

  mesh.update();

  // Send to the master node every second
  if (millis() - displayTimer >= 0) {
    displayTimer = millis();

    // Send an 'M' type message containing the current millis()
    if (!mesh.write(&displayTimer, 'M', sizeof(displayTimer))) {

      // If a write fails, check connectivity to the mesh network
      if ( ! mesh.checkConnection() ) {
        //refresh the network address
        serial.println("Renewing Address");
        mesh.renewAddress();
      } else {
        serial.println("Send fail, Test OK");
      }
    } else {
      serial.print("Send OK: "); serial.println(displayTimer);
    }
  }

  while (network.available()) {
    RF24NetworkHeader header;
    payload_t payload;
    network.read(header, &payload, sizeof(payload));
    serial.print("Received packet #");
    serial.print(payload.counter);
    serial.print(" at ");
    serial.println(payload.ms);
  }

  delay(5);
}
